ywbdxxm/MC100/MC100-SCHEMATIC-REVIEW.md

# MC100 原理图功能与电气复核

复核日期：2026-09-08。设计依据：立创 EDA 专业版云工程 `MC100` 当前五页原理图及已完成的原理图/PCB 网络对账。本文是审查结果，不是样机测试合格证；本次没有修改 EDA 电路。

**结论：主控、充电、PDM 采音、SDMMC 存储的架构具备实现目标的基础，未发现已核对引脚的错接、短路或漏接。明确的功能限制是关机文件完整性；充电计时、USB 输入和供电余量仍有具体待验证项。麦克风接线未发现明确错误，F02 属于资料澄清与样机验证，不应与已确认的硬件功能限制等同。所有功能的整机验收仍须实测。**

用户已确认电池已选定，为带独立 10 kΩ NTC 的三线电池。电池具体型号、容量、保护板参数、NTC 曲线及 microSD 型号尚未记录在本项目中。本文按现有产品目标讨论 1200 mAh，不把它当作用户已经确认的电池实参。

## 1. 主要发现

### F01 高优先级：拨动 OFF 无法保证先保存录音

**确定的硬件能力限制。** P2 的 SW1.1 接 `+VSYS_RAW`，SW1.2 接 `LDO_EN`，SW1.3 未连接，R5=100 kΩ 下拉；P1 的 U2.3 是 LDO EN。没有 MCU 开关检测线、供电保持或软件关断控制。U2 关闭后还会主动放电输出电容。[S1，第 14 页]

因此，用户在 SD 写入、WAV 文件头更新或文件系统元数据更新时拨到 OFF，会直接中断供电。定期同步、临时文件和上电修复可降低损失，但不能保证每次关机文件完整，也不能仅凭它们承诺已完成文件永远不受影响。

处理建议：若正常关机必须完整保存，增加“关机请求 -> MCU 收尾 -> 确认 SD 写入结束 -> 受控断电”的电路。若保留目前的直接断电方式，产品要求必须接受经过所选卡型实测确定的损失和恢复边界。低电检测同样只能让固件提前收尾，当前 MCU 不能关闭 LDO。

### F02 资料澄清与样机验证：麦克风 DATA 电平

**接线未发现明确错误，建议保留当前麦克风接口用于样机验证；目前没有仅凭本项就必须改线、增加电平转换或更换麦克风的依据。** P4 的 U4.1 `PDM_DATA` 直连 U3.5 / GPIO1；麦克风与 S3 均由 3.3 V 系统供电，麦克风支路经过 FB1。供电、引脚和 1.024 MHz 目标时钟范围匹配。[S2，第 1-3 页]

复核澄清：原先将本项列为高优先级，未充分区分“规格资料不足”与“已确认功能缺陷”，现调整分类。下表的原始数值及缺少实际负载下输出保证这一事实不变，调整分类不代表已测得电平合格。

| 方向/指标 | 厂商原表 | 按两端均为 3.3 V 换算 |
| --- | --- | --- |
| ZTS6872SE Logic Input/Output High 最小值 | 0.65 × VDD，Iout=1 mA | 2.145 V |
| S3 输入 VIH 最小值 | 0.75 × VDD | 2.475 V |
| ZTS6872SE Logic Input/Output Low 最大值 | 0.35 × VDD，Iout=1 mA | 1.155 V |
| S3 输入 VIL 最大值 | 0.25 × VDD | 0.825 V |

以上来自麦克风 DS-1.6 第 3 页原表及 S3 v2.2 第 62 页表 5-4。[S2、S3] 若把麦克风合写的输入/输出指标按输出保证边界比较，高、低电平各差 0.330 V。这是手册边界值的比较，不是板上测得的电平差，也不足以判定实际 DATA 直连不兼容。现有资料尚不能给出完整的最不利条件静态噪声裕量保证。

麦克风把输入和输出电平合写在同一行，测试负载为 1 mA；S3 实际是高阻输入，原表输入漏电流最大值为 50 nA，另有输入电容和 PCB 动态负载。较轻的负载下实际输出可能更接近电源轨，但这一点还没有厂家补充规格或本板实测支撑。先取得钰太对 DATA 输出 VOH/VOL 的定义及实际负载、工作电压和温度范围下的保证，并在样机 S3 引脚处测量有效采样窗口内的 DATA 高低电平、振铃及建立/保持时间，覆盖 SD 写入和 USB 插拔工况。只有确认裕量不足，或量产所需保证始终无法取得时，再评估缓冲器或替代麦克风；不以表格歧义直接要求改板。

反向 CLOCK 的静态门限比较没有同样的缺口：S3 高阻负载 VOH≥0.8×VDD、VOL≤0.1×VDD，可满足麦克风原表的 0.65/0.35 门限；动态波形仍需测试。[S2、S3]

### F03 中优先级：安全充电计时需要按公差和实际电池复核

P1 的 R3=3 kΩ，R2=46.4 kΩ。BQ24073 的 KISET 为 797/890/975 AΩ，KTMR 为 36/48/60 s/kΩ；两只电阻为 1%。[S4，第 13、34 页]

| 项目 | 计算结果 |
| --- | --- |
| 标称快充电流 | 890 / 3000 = 296.7 mA |
| 含上述公差的设定电流范围 | 约 263.0-328.3 mA，未计动态限流/热调节 |
| 标称快充安全计时 | 10 × 48 × 46.4 / 3600 = 6.187 h |
| 含上述公差的计时范围 | 约 4.594-7.811 h，按未减速的计时条件 |

文档原来的“约 6.25 小时”来自 46.8 kΩ 的示例计算，应按当前 46.4 kΩ 写为约 6.19 小时。更重要的是，若沿用 1200 mAh、约 5-6 小时充满的预估，不能仅凭标称 6.19 小时认定计时余量充足。

这不证明一定会提前超时：BQ24073 在 DPPM、输入 DPM 或热调节减小充电电流时会同比放慢计时，NTC 故障时暂停计时。[S4，第 28-29 页] 应结合所选电池的充电曲线，覆盖低电、边录边充及公差条件；不足时重新选定 TMR 阻值，同时保留适合电池的安全时间限制。U1 的 CHG# 未接 MCU/LED，超时故障目前也不能由固件直接读取。

### F04 中优先级：USB 输入电容没有显式的浪涌余量

P1 的 C2=10 µF、C10=100 nF 均直接跨接 `+VBUS_USB` 与 GND，标称合计 10.1 µF。BQ2407x 原文要求器件前端的输入电容小于 10 µF，因这部分充电电流不经过芯片内部限流；后级大电容受限流保护不能代替前端约束。[S4，第 21 页，§9.3.4.1、图 9-2]

当前标称选值没有为该约束留出余量。实际插入浪涌还取决于电容公差、随电压变化的电容值、供电源和连接阻抗，不能只凭 10.1 µF 断言实测一定超标。建议把 C2 复核为有公差余量的输入电容值，例如评估 4.7 µF，并验证输入稳定性及插入电荷/电流。

另外，EN2 固定接地、EN1 固定接 VBUS，使充电器始终使用 USB500 模式。R1=3 kΩ 不是当前 500 mA 档位的设定来源，固件也不能切换 USB100 或 USB suspend。USB500 是芯片限流模式名称，不等于整机完成了 USB 主机端口枚举、挂起或 Type-C 供电合规验证。连接电脑的兼容性仍须单独验证。

### F05 中优先级：1 A LDO 标称不能替代温升和低电供电验证

U2 确认为 `TLV75733PDBVR`，是无裸露散热焊盘的 DBV SOT-23-5。引脚和 EN 接法正确，输入/输出电容标称值处于手册建议范围。[S1，第 3-6 页] 不应引用 DYD 带散热焊盘版本的热参数。

在 USB 有效且供电足够时，BQ24073 OUT 标称为 4.4 V。[S4，第 6 页] LDO 耗散约为 `(4.4-3.3) × Iload`。举例，持续 300 mA 时为 0.33 W；DBV 的 JEDEC 测试板热阻 231.1 °C/W 对应约 76 °C 温升，EVM 条件下则为 100.8 °C/W。这些是不同测试板数据，不能当作 MC100 实际热阻或上下界。[S1，第 5 页] 必须在装壳、边录边充及最长 SD 忙周期下测温、测电源跌落。

电池低电时 LDO 不升压，进入 dropout 后瞬态表现会变差；从 dropout 恢复还可能有过冲。[S1，第 14 页] 电池 ADC 阈值必须保证先停止写盘，并避免低电复位后反复挂卡/写盘。当前电路不具备软件彻底断电能力。

## 2. 已确认的连接与功能基础

以下结论限于列明的原理图连接及所引用的器件能力，不表示 F01-F05 已解决或样机已通过验收。

| 模块 | 本次核对 | 结论/约束 |
| --- | --- | --- |
| 电池接口 J1 | 1 脚正极经 R4=0 Ω 到 BAT；2 脚到 TS；3 脚 GND | 与用户确认的三线 NTC 电池形式匹配；实物线序必须为 BAT+/NTC/BAT-，NTC 另一端接 BAT- |
| BQ24073 | BAT 2/3、OUT 10/11 均连接；IN 13、GND 8/17；CE#、TD 接地；TS 到 J1.2 | 充电和终止使能；系统/充电共用 USB500 输入预算；管脚定义符合 BQ24073 列 [S4，第 8-9 页] |
| 电池温度检测 | 三线 10 kΩ NTC 已确认；TS 未用固定电阻旁路 | 在典型 75 µA 偏置下，25 °C 的 10 kΩ 对应 0.75 V；典型冷热阻值门限约 28 kΩ / 4 kΩ。温度值依赖实际 NTC 曲线及误差 [S4，第 13-14 页] |
| LDO/开关 | U2 1 IN、2 GND、3 EN、4 NC、5 OUT；SW1 驱动 EN，R5 下拉 | 可以实现开关系统电源、关机插 USB 充电；不能实现提前收尾关机 |
| MCU 最小系统 | U3 为 ESP32-S3-MINI-1-N8；3V3、全部地脚、EN 10 kΩ/1 µF、GPIO0 10 kΩ/测试点 | 已核对模组焊盘映射；USB 下载及 BOOT/EN 测试入口存在 [S5，第 10-11 页] |
| PDM 麦克风 | U4 1 DATA -> GPIO1，4 CLOCK 经 R14=22 Ω -> GPIO2；2 SELECT、3 GND 接地；5 VDD 经磁珠供电 | 供电、脚序、去耦和时钟范围匹配；DATA 电平见 F02 |
| PDM 转 PCM | I2S0 硬件支持 64 倍降采样；1.024 MHz / 64 = 16 kHz | 能支持目标格式；SELECT=0 在下降沿后驱动、上升沿后高阻，应验证固件的有效槽位/采样沿；启动稳定时间最大 25 ms [S2，第 1-4 页；S6，第 1006 页] |
| SDMMC 1-bit | GPIO8 CMD、GPIO7 经 R22=22 Ω 到 CLK、GPIO6 DAT0；CMD/DAT0-DAT3 均有 10 kΩ 上拉 | 符合 S3 GPIO 矩阵及官方 SD 上拉要求；未接 MCU 的 DAT1-DAT3 也已上拉 [S6，第 1195 页；S7] |
| 卡检测 | J3 独立 CD 接 GPIO5，R20=10 kΩ 上拉；卡座壳地已接 | 与总线 DAT3 独立；实物 CD 开闭状态仍需通断测量 |
| USB 数据 | CC1/CC2 各 5.1 kΩ 下拉；两组 D- 合并经 22 Ω 到 GPIO19，两组 D+ 合并经 22 Ω 到 GPIO20 | 双面插头对应的数据脚均已连接，未发现 D+/D- 对调；浪涌及供电模式见 F04 |
| LED | U3.25 / GPIO21 经 R8=3.3 kΩ 驱动 LED1 | 实际 GPIO 是 21；网络名 `GPIO7_LED` 会误导固件，GPIO7 实际用于 SD CLK |
| 电池 ADC | GPIO4，R6=1 MΩ / R7=330 kΩ，C11=100 nF | 4.2 V 对应约 1.042 V；分压耗流约 3.16 µA，RC 时间常数约 24.8 ms；需校准、等待稳定并检查关机漏电 |

BQ24073 原表的约 0 °C / 50 °C 温度说明针对 Vishay Type 2、R25=10 kΩ 的 NTC 曲线，不能推广到任意 10 kΩ 电池。所选电池的允许充电温度、NTC 曲线和线序需要形成供应商规格记录，再验证低温、高温、NTC 开路/短路均暂停充电。[S4，第 13-14、29 页]

## 3. 产品功能判定

| 产品目标 | 现有硬件判定 | 尚需证据 |
| --- | --- | --- |
| 持续监听、人声触发录音 | 架构支持；监听时 S3 和 PDM 必须持续工作 | F02 接口验证、实际 VAD 漏检/误触发、任务调度及功耗 |
| 16 kHz / 16-bit / mono | 支持，数据率 32,000 byte/s | 实际采样率、有效声道、噪声与掉帧测试 |
| 2 秒预录、静音后收尾 | 2 秒 PCM 需 64,000 byte；有实现基础 | N8 无 PSRAM，VAD/任务栈/DMA/预录/写盘缓冲的峰值内存需联合验证；不能推定任意 AI 模型均可用 |
| microSD 长期存储 | 1-bit 带宽足以承载 PCM | 所选卡的最长忙时间、待机/写入电流、写入寿命、满卡/坏卡/拔卡处理 |
| 滑动开关开关机 | 可以直接切换系统供电 | 正常关机文件完整性未满足保证条件，见 F01 |
| 关机充电、边充边录 | Power Path 架构支持 | 电池实参、F03 计时、F04 USB 输入、F05 温升和切换波形 |
| 充电中/充满状态指示 | 当前没有专用状态通道 | PGOOD#/CHG# 均未连接；不能把 GPIO21 的系统 LED 当作可靠充电状态灯 |
| 单次充电工作 24 小时 | 未证实 | 若电池为 1200 mAh、可用容量按 80%，平均电池电流上限为 40 mA；现有设计目标 35 mA 仍须覆盖真实语音占比和 SD 卡实测 |

当前未提供 MC100 固件工程和已验证固件版本，因此本次没有固件构建、刷机、录音、温升或续航测试。S7 使用现有设计文档引用的 ESP-IDF v6.0.2 官方资料核对硬件要求，不代表固件已经选用该版本。

## 4. EDA 检查结果

| 页 | 放置项 | 官方原理图 DRC | 短接桥/孤立导线检查 | 严格检查总结果 |
| --- | ---: | --- | --- | --- |
| P1_POWER_PATH | 17 | 0 项 | 0 项 | 通过 |
| P2_POWER_CONTROL | 8 | 0 项 | 0 项 | 通过 |
| P3_MCU_DEBUG | 10 | 0 项 | 0 项 | 通过 |
| P4_USB_AUDIO | 10 | 0 项 | 0 项 | 未通过：1 条图签告警 |
| P5_SDMMC_STORAGE | 11 | 0 项 | 0 项 | 通过 |

P4 已通过页面 UUID 直接读取图签：`Name`、`Drawed`、`Description` 为空，产生 `missing-titleblock`。这是文档完整性问题，未发现对应的电气违规；仍不能把“五页严格检查全部通过”作为交付状态。

此前同日完成的原理图/PCB 对账为 56 个放置项、234 个焊盘记录、无网络差异；PCB 官方 DRC 为 0 项。本次以五页原理图的语义网络、严格检查和数据手册复核为主，没有把此前 PCB DRC 当作热设计、阻抗、声孔、ESD 或整机可靠性测试。

## 5. 样机验证顺序与剩余边界

1. 接电前核实电池正负极/NTC 实物线序、保护板和 R4 电流能力；量测电源对地阻抗。验证两种开关状态，以及电池/USB 各种接入顺序。
2. 用实际电池或电池模拟设备完成充电全过程，记录 IN/BAT/OUT/TS、电流及温度；核对终止、计时和冷热保护。保护板截止不能替代录音系统的提前低电收尾。
3. 测量 3.3 V、EN 和复位波形，覆盖启动、SD 写入、低电及 USB 插拔；测试装壳温升。关机时测 ADC/USB 引脚是否向失电系统注入电流，并记录实际关机电流。
4. 先验证连续原始 PCM：1.024 MHz PDM 时钟、有效采样窗口内的 DATA 裕量、正确声道及启动稳定时间，再加入 VAD 和 2 秒预录。正常运行应零丢帧，异常必须有计数和明确状态。
5. SD 从 20 MHz 验证，稳定后再评估 40 MHz；记录最长忙时间并据此验证缓冲容量。完成满卡、无卡、故障卡、插拔和长录音测试。
6. 在录音写入、文件头/元数据同步、文件轮换时分别执行不少于 100 次随机硬关机，检查当前文件、已完成文件及文件系统；这些次数是项目验证目标，不是已经完成的结果。
7. 以选定电池、选定 SD 卡、装壳和实际语音占比完成 24 小时电流积分/续航测试。再确认底部进音声孔、密封/透声膜、佩戴摩擦噪声和接口静电表现。

本次未取得 J1/J2/J3/SW1 全部连接器的原厂机械图及实物通断证据，未逐项完成无源器件耐压、直流偏压曲线和浪涌额定值审核。已有库符号/PCB 焊盘的一致性不等于这些独立验证已经通过。USB/SD 接口当前没有专用板载 ESD 保护，相关鲁棒性属于未验证项。

## 6. 证据与版本

关键表格均回看哈希一致的原 PDF 页面。已有 ESPDocs 语料用于定位；本次对未索引的麦克风和 LDO，先评估原生文本，再对麦克风第 1-4 页、LDO 第 3-6 页进行本地 Docling 表格/结构提取，并按原页复核。单次提取结果与截图不作为项目设计正本。

| 编号 | 精确资料/版本 | 本次相关物理 PDF 页 |
| --- | --- | --- |
| S1 | [TI TLV757P，SBVS322C，2024-03](../docs/PMIC/TLV757P.pdf)；按 DBV 封装列取值 | 3-6、14 |
| S2 | [钰太 ZTS6872SE，DS-1.6](../docs/MIC/C6E5017425694CD9DA32466A7E3CEEEF.pdf) | 1-4 |
| S3 | [ESP32-S3 芯片规格书，中文 v2.2](../docs/ESP32-S3/esp32-s3_datasheet_cn.pdf) | 62，表 5-4 |
| S4 | [TI BQ2407x，ZHCSIF0N，2021-10](../docs/PMIC/bq2407x.pdf)；按 BQ24073 列取值 | 6、8-9、13-14、21、28-29、34 |
| S5 | [ESP32-S3-MINI-1/MINI-1U，中文 v1.7](../docs/ESP32-S3/esp32-s3-mini-1_mini-1u_datasheet_cn.pdf)；模组管脚为此前同日已复核依据 | 10-11，表 3-1 |
| S6 | [ESP32-S3 技术参考手册，中文 v1.8](../docs/ESP32-S3/esp32-s3_technical_reference_manual_cn.pdf) | 998、1006、1195 |
| S7 | [Espressif ESP-IDF v6.0.2，SD Pull-up Requirements](https://docs.espressif.com/projects/esp-idf/en/v6.0.2/esp32s3/api-reference/peripherals/sd_pullup_requirements.html)；读取同版本官方 RST 源文件，按 ESP32-S3 条件解释 | 总要求、SOC_SDMMC_USE_GPIO_MATRIX / esp32s3 分支 |

S6 第 998 页的下采样公式与第 1006 页位定义存在不一致；本次以第 1006 页明确的 `0 -> 64、1 -> 128` 位定义核对 64 倍能力，不依据第 998 页公式推导寄存器配置。固件应使用已选 SDK 的对应驱动，并实测输出采样率。

| 资料 | SHA-256 |
| --- | --- |
| S1 | `d9372b60e97388b566b571a335b771255d3654306ce55c265e62a51f5a9709a9` |
| S2 | `0c206c8147227ef4b88e4fcd5a20196f24c0b13539ad8e38918a7c556bd545bf` |
| S3 | `adee5f18f1b565cf386f0b3feed7c437bcc1a8e57619e922198da2d47f96b400` |
| S4 | `2dbe769d0d1ddf698c8a118394787e1e450714cf38b33df77f43695f9ffc91a9` |
| S5 | `a4c94c131b2a2b37c46b2f65495c6f5fdbf001f3a357fee6035190a005663816` |
| S6 | `08b5edd2bf196eb27316d0b94fb50201d8faa5d75b1f2716ff83e1452b229500` |
