ywbdxxm/MC100/.superpowers/sdd/2026-09-25-mc100-audio-level/task-2-report.md

# Task 2 report: portable PCM processing

## Result

Implemented the stateful fixed point PCM filter for MC100 audio. The filter owns a Q16 DC estimate,
input and output peaks, and a clipped sample counter. It validates its arguments before mutating
state or samples, uses 64 bit intermediates, updates the DC estimate with the specified `/ 512`
rule, applies gain before the single Q16 conversion, clamps to signed 16 bit range, and records
peak magnitudes with 32768 represented for `INT16_MIN`.

## Files

- `firmware/components/mc100_audio/include/mc100_pcm_filter.h`
- `firmware/components/mc100_audio/pcm_filter.c`
- `firmware/tests/test_pcm_filter.c`
- `firmware/components/mc100_audio/CMakeLists.txt`
- `firmware/host/CMakeLists.txt`

## TDD evidence

The focused host test was first run against the unimplemented stub and failed at the identity
assertion (`MC100_OK` expected, `MC100_INVALID` returned). After implementation the same focused
test passed.

## Verification

Environment: VS 2022 Build Tools 17.14.40 Developer PowerShell, MSVC 19.44, Espressif CMake 3.30.2,
Ninja 1.12.1, C11.

Commands:

```text
cmake -S firmware/host -B firmware/out/host-audio-task2 -G Ninja -DCMAKE_BUILD_TYPE=Debug -DMC100_ENABLE_FUTURE_RUNTIME_TESTS=OFF
cmake --build firmware/out/host-audio-task2 --target test_pcm_filter
ctest --test-dir firmware/out/host-audio-task2 -R '^pcm_filter$' --output-on-failure
```

Result: `pcm_filter` passed.

```text
cmake -S firmware/host -B firmware/out/host-audio-task2-full -G Ninja -DCMAKE_BUILD_TYPE=Debug -DMC100_ENABLE_FUTURE_RUNTIME_TESTS=OFF
cmake --build firmware/out/host-audio-task2-full
ctest --test-dir firmware/out/host-audio-task2-full --output-on-failure
```

Result: all 17 default host tests passed.

## Coverage

Host vectors cover bypass identity, full negative peak magnitude, constant offset removal, the
`[0, 1000]` DC step, the low level `[0, 1]` step at 8x, gain and saturation boundaries, clipping
counts, invalid arguments with no mutation, and whole-buffer versus chunked state continuity.

## Scope and concerns

No product capture loop, EVT path, writer, or SD-card files were changed. Target firmware and physical
microphone behavior were not exercised in this host-only task.
