ywbdxxm/MC100/MC100-PCB-REVIEW.md

# MC100 PCB 投板前复核

复核日期：2026-09-09。权威对象：立创 EDA 云工程 MC100，项目 UUID `b3848130180c4bfb8066a08134a93953`，PCB1 UUID `588d07309976e518`。

本次直接读取当前 PCB 和五页原理图，运行原生 DRC，并于 01:03:19 重新导出 Gerber。00:55:33 的初始数据与 01:27:34 的收尾数据对比确认：元件、焊盘、走线、过孔、铺铜、填充、禁布区、丝印和规则没有变化。本轮未修改电路或封装，未提交制造订单。

**结论：未发现新的短路、断线或原理图与 PCB 网络不一致。之前的麦克风实心锡膏开口和 USB/SD 走线中段跨电源分割问题已经解决。建议再完成 USB 局部回流、SD 去耦、R22 和 LDO 输出电容的布局收尾，并按实际制造叠层确认阻抗后打样。**

这些布局建议涉及信号及供电余量，尚未通过样机测量量化影响；不能将其描述为已发生的烧录、录音或写卡故障。DRC 通过也不能代替真实功能验证。

本轮 [检查数据及制造副本](../.easyeda/reviews/MC100-20260909-0051/)；[2026-09-08 历史复核全文](../.easyeda/reviews/MC100-20260909-0051/previous-review-20260908.md)。历史文件中的“当前”均指旧版。

## 1. 建议投板前收尾的项目

### P06 USB 局部参考铜与换层回流

USB_P/USB_N 主干已经从 Bottom 移到 Inner2，参考 Inner1 地平面。新 Gerber 中，直线中心线在自身信号过孔周围 0.65 mm 之外，没有再跨过参考铜的空白区。进一步按完整线宽检查，仍有两处局部边缘投影落入地平面的过孔避让：

| 位置 | 当前证据 | 建议 |
| --- | --- | --- |
| NTC 过孔附近 | `$1N267` 过孔位于 EDA (655, 231.9708) mil，即 Gerber (16.6370, 5.8921) mm。USB_N 的边缘在 x 16.3357-16.9383 mm、y 5.3305-5.4182 mm 局部进入其 Inner1 反焊盘范围，投影面积约 0.0358 mm² | 将 NTC 过孔稍远离 USB 对，保持两根 USB 线原有平行关系，并重新核对参考地 |
| MCU 端换层附近 | USB_P 在 Gerber x 42.5261-42.6589 mm、y 5.1137-5.2270 mm 处，线边缘接近 USB_N 过孔的反焊盘；自身过孔 0.65 mm 范围以外的投影面积约 0.00326 mm² | 整理差分对的过孔和扇出，减小相互反焊盘对直线段的影响 |
| 两端换层地回流 | 连接器端两颗 USB 过孔距最近独立 GND 过孔约 3.64/4.08 mm；MCU 端约 2.50/3.31 mm | 在两端的差分换层附近补就近地过孔，按原厂建议为差分对提供成对的地回流 [D2] |

上表是几何位置和最近独立地过孔距离，不是实测回流长度或阻抗。信号自身过孔处的反焊盘是正常结构，不把它整体判作跨分割缺陷。0.65 mm 是本次分析排除正常过孔邻域的口径，不是厂商规定的安全距离。

[USB 局部定位图](../.easyeda/reviews/MC100-20260909-0051/usb-reference-details.png)：灰色为实际 Inner1 地铜，红色仅标出自身过孔邻域以外的线边缘投影空白。此项是局部信号余量建议，不表示 NTC 与 USB 短路。

### P02 SD 高频去耦 C20 仍离卡座较远

C20=100 nF，仍位于 EDA (960, 800) mil。J3.4 是 microSD 电源脚。

| 电容 | 容量 | 电源焊盘到 J3.4 的中心直线距离 |
| --- | --- | ---: |
| C18 | 47 uF | 5.69 mm |
| C19 | 10 uF | 7.83 mm |
| C20 | 100 nF | 9.38 mm |

优先将 C20 移到 J3.4 附近，地端就近接地平面；空间允许时把 C19 一起收拢。当前 C20 地焊盘距最近独立地过孔约 3.29 mm，也值得同时缩短。电源铜面和远处的大电容已存在，但高频去耦仍应缩短供电与接地回路。

### P01 SD 时钟串阻 R22 仍在卡座端

R22=22 ohm，仍位于 EDA (705, 920) mil。线路为 U3.11 / GPIO7 -> `SDMMC_CLK_MCU` -> R22 -> `SD_CLK_CARD` -> J3.5。MCU 到 R22 的网络铜线总长约 19.34 mm，R22 到卡座约 2.36 mm。

如果以源端串联阻尼为目的，建议把 R22 放到 U3.11 附近，使电阻之前的走线尽可能短。当前摆放将大部分走线留在阻尼电阻之前。此建议基于串联阻尼的作用位置，并非已测得时钟振铃；实际效果还取决于驱动边沿、卡负载及叠层。

### P07 LDO 输出电容 C8 宜靠近 U2

U2 为 TLV75733PDBVR，当前位置 EDA (1475, 240) mil；C8=22 uF，位于 (1425, 75) mil。C8 电源焊盘距 U2.5 / OUT 约 5.45 mm；C9=100 nF 的对应距离约 2.77 mm。输入旁的 C5 距 U2.1 约 2.98 mm。

建议优先把 C8 和 C9 收拢到 OUT/GND 附近，并缩短接地回路。TI 的布局要求是输入、输出电容尽可能靠近器件，同时使用铜面和附近过孔改善散热 [D5]。当前连接完整，不能仅凭这些距离认定 LDO 已失稳或一定掉压。

## 2. 已解决及已通过的检查

### P04 麦克风声孔与锡膏开口保持正确

U4 仍使用修正后的局部封装 `588d07309976e518_4dd9d81a1a9fda28`，其焊盘、填充、轮廓和属性记录与 2026-09-08 已验证版本相同。本次新导出的制造数据也确认：

| 项目 | 新 Gerber 实测 |
| --- | --- |
| 声孔 | (25.65387, 28.26487) mm，直径 0.60000 mm，属于 NPTH |
| 接地环锡膏 | 4 个互不相连的环形扇段，四个矩形开口仍保留 |
| 中心留空直径 / 外径 | 1.024943 / 1.625019 mm |
| 四处分隔 | 每处约 0.199998 mm |
| 与声孔重叠面积 | 0 |
| 锡膏距声孔边缘 | 最小约 0.212472 mm |

这些尺寸与 ZTS6872SE DS-1.6 第 9 页的钢网建议一致 [D1]。小数差异来自圆弧近似和 Gerber 取整。[本次实际 GTP 图](../.easyeda/reviews/MC100-20260909-0051/current-mic-paste.png)；[历史修复证据](../.easyeda/reviews/MC100-MIC-FIX-20260908/)。SMT 工厂仍应使用修复后的制造文件及钢网。

### P05 旧的线路中段跨电源分割已消除

新版本的 Inner2 为大面积 GND、局部 +3V3_SYS 铜区及 USB 差分走线；旧的 +VBUS_USB、+VSYS_RAW 内层电源铺铜不再存在，两网改由实际外层走线和局部填充供电。

- USB 主干在 Inner2，两侧分别为 Inner1 地平面和 Bottom 铜层。两侧实际地铜均已核对，直线中心线在自身信号过孔邻域之外均未再跨地铜空白。实际主要参考哪侧仍取决于制造层间距。
- SD_CLK/CMD/DAT0 和 PDM 的长段仍在 Bottom，下方对应 Inner2 地铜。
- 以实际 Gerber 连通铜区识别地铜后，检查直线中心线并排除自身过孔 0.65 mm 邻域，没有再发现旧版的中段跨铜面分割。
- 完整线宽的局部边缘问题单独列在 P06，不能把“旧分割消除”扩写为全部信号完整性已经通过。

[当前信号与参考地叠加图](../.easyeda/reviews/MC100-20260909-0051/current-reference-layers.png)。本次 G1/G2 中，异网独立过孔的铜环与已识别地铜的最小几何间距约 0.257 mm，未见它们直接连进地平面。

[USB 与另一侧 Bottom 地铜叠加图](../.easyeda/reviews/MC100-20260909-0051/usb-over-bottom-reference.png)。不能仅因存在连续的 Inner1 就假定它一定是 Inner2 的最近参考层，本轮已补查另一侧，但真实阻抗仍需制造叠层。

### P03 原先六处丝印压焊盘提示未在制造文件中重现

对 C4、R8、R15、R12、R17、U1 的实际 GTO 字形及周边图形与 GTS 开窗相交检查，局部重叠面积均为 0；每个检查区域内均确认存在实际丝印图形。本次不再把这六条包围盒提示列为已确认的压焊盘问题。

R15/R12/R8 仍排得较密，部分文字与器件框接近，建议作可读性整理，优先级低于供电和信号回流。[实际丝印与阻焊叠加图](../.easyeda/reviews/MC100-20260909-0051/current-silkscreen-detail.png)。

### 连通、供电、结构与调试入口

| 项目 | 当前结果 |
| --- | --- |
| 原生 DRC | 本次 `passed=true`，`violations=[]`；用户运行的原生界面也显示 124 项检查、0 问题 |
| 原理图与 PCB 对账 | 五页重新读取；56 个放置项、234 个焊盘记录，无缺失、网络差异或采购料号差异 |
| 实际有效走线 | 255 个直线段：Top 221、Bottom 26、Inner2 8；另有 Top 圆弧 4 个 |
| 独立过孔 | 78 个，孔径均为 12 mil、外径均为 24 mil，约 0.305/0.610 mm |
| 铜区 | 可枚举铺铜 4 区，顶层静态电源填充 6 区；Inner1 另有实际 GND 平面，不因接口不可枚举而判为空 |
| 电源导线 | 实际直线宽度为 10/20 mil，并配合局部铜面；不能用是否存在同名 pour 判断供电路径是否完整 |
| U1 接地/散热 | EP 为 GND，中心有 2 x 2 共 4 颗地过孔；温升仍需样机验证 |
| U3 接地 | 模组中央 9 块地焊盘各有地过孔，焊盘网络保持一致 [D4] |
| 模组/麦克风去耦 | C15 到 U3.3 约 1.66 mm；C17 到 U4.5 约 1.56 mm |
| 开关与 LDO | SW1.1=VSYS_RAW、SW1.2=LDO_EN、SW1.3=NC；R5=100 kohm 下拉，U2 EN/IN/OUT/GND 对账一致 |
| 板框 | 实际约 50 x 30 mm，带天线外伸缺口；四个铜层都没有导出板框外铜 |
| 最小铜到板边 | Top 约 0.376 mm、Bottom 约 0.356 mm、Inner1 约 0.257 mm、Inner2 约 0.505 mm，含缺口边界 |
| 天线禁布 | 多层禁止 TRACK/COPPER/FILL/PLANE；禁布矩形与四层实际铜的相交面积均为 0 |
| TP1-TP4 | 底层分别为 GND、3V3、GPIO0/BOOT、EN/CHIP_PU，铜盘直径 0.762 mm、阻焊开窗约 0.8636 mm，实际丝印镜像正确 |
| 下载线路 | USB D-/D+ 经 R15/R12 分别到 GPIO19/GPIO20；GPIO0、EN 测试点铜连接保留。UART0 TX/RX 仍未引出；操作条件见 [烧录文档](MC100-PROGRAMMING.md) |

原生源码另保留 53 个长度小于 0.0471 mil 的极短 LINE 记录，读取接口的有效走线计数没有包含它们。上述 255 段采用同一接口口径，制造图形检查使用完整 Gerber，并未只渲染这 255 段。

### SD 与 USB 长度

本次按 U3 焊盘中心到 J3 焊盘中心重建实际导电路径，排除上拉支路，并将 R22 两焊盘之间约 0.864 mm 的跨度计入时钟路径。各路径均有两次换层；下表不包含过孔孔壁传播延迟或器件内部延迟。

| SD 信号 | 点到点长度 | 相对 CLK |
| --- | ---: | ---: |
| CLK | 22.568 mm | 基准 |
| CMD | 22.231 mm | -0.337 mm，约 -13.28 mil |
| DAT0 | 22.839 mm | +0.271 mm，约 +10.66 mil |

本次使用的 CMD/DAT0 满足原厂相对 CLK ±50 mil 的几何等长建议，长度也小于推荐的 2000 mil [D2]。[逐段路径数据](../.easyeda/reviews/MC100-20260909-0051/sd-path-lengths.json)。这不等于已做时序仿真，也不会消除 R22 位置及去耦建议。

USB 工具统计接口侧两网铜长差约 0.25 mil，MCU 侧约 0.64 mil；MCU 到串阻约 2.23/2.25 mm。接口侧统计包含 USB-C 分支，不能当成纯粹的点到点差分延迟。

## 3. 制造与样机验证边界

| 项目 | 当前尚缺的证据 |
| --- | --- |
| 阻抗 | 没有板厂确认的四层介质间距、铜厚和介电参数。USB 已换到 Inner2，10 mil 线宽、6 mil 长平行段边缘间距仍需按该层实际结构核算，不能直接认定满足 90 ohm ±10%；SD 50 ohm ±10% 同样未计算 [D2] |
| SMT | U3/C2913206 与 U4/C42372687 的现有选型需要标准型服务；最终 BOM、坐标文件、Gerber、工厂钢网需同版。TP 不作为采购器件 |
| 电池/连接器 | 用户已确认三线、10 kohm NTC 电池；实物仍需匹配 J1.1=BAT+、J1.2=NTC、J1.3=GND。连接器实际插拔空间、外壳和电池对天线的影响尚未独立验证 |
| 功能 | 未进行实体上电、USB 烧录、录音、写卡、充电或温升测试；开关关闭仍会直接关断 3V3，不具备软关机保持电路，写卡中掉电风险见 [原理图复核](MC100-SCHEMATIC-REVIEW.md) |

建议完成第 1 节收尾和叠层确认后，重新跑 DRC、导出并检查制造文件。下述 ZIP 是本次复核快照，不是已经放行的最终下单包。

## 4. 补充检查与布局评分

补充 `pcb check` 返回 `passed=false`。findings 数组实际为 49 ERROR、165 WARN、14 INFO，共 228 条；工具 summary 的 warnings=173 与数组不一致，本文采用逐条计数。

- 41 条间距 ERROR 存在单位二次换算：原始规则单位为 mil，约 5.9843 mil 被当成约 235.6 mil。例如 USB_CC2 到 C1.2 的 231.1 mil 距离被误判不够；不将这些结果当作真实间距违规。
- 8 条镜像 ERROR 来自没有渲染包围盒的库属性；实际底层 TP 位号均为 `mirror=true`。
- 59 条 silk-over-pad 中仅 6 条涉及有可见包围盒的位号，已用真实 GTO/GTS 重新判断，见 P03。
- `USB_P` 的 single-layer-via 漏计顶层圆弧；该孔实际连接 Top 和 Inner2。
- 4 个 power-not-poured 提示没有计入同网静态填充和实际走线；本轮分别核对 +VBAT、+VBUS_USB、+VSYS_RAW、+3V3_MIC。
- width-under-spec 将原始 10 mil 读成约 393.7 mil，不能据此要求全部电源线加宽到 394 mil。
- C18-C20 被按 MCU 去耦误分配；本轮用实际负载 J3 重测，保留 P02。C8/C9 的真实距离建议则保留为 P07。
- Inner1 平面不可枚举提示已用完整 G1 和原生 LAYER_FILL 记录排除；实际异网过孔与地铜隔离也已核对。
- 其余角度、宽度变化、3W、散热过孔、Mark 点等属于工艺或布局提示，需要按实际网络和贴装工艺判断，未将整份补充报告标为全部通过。

布局评分仍为 73.4/100，`fair`，七维计分、两维跳过。只是诊断，未作为放行门槛；工具未返回 `blocking[]` 字段，compact 中 `hardCollisions=0` 不能扩写为所有结构检查均通过。

| 维度 | 分数 | 主要归因与限制 |
| --- | ---: | --- |
| 功能分区 | 40 | 降级：按网络猜分组，R5/U2/J1 被扣分；没有设计意图 spec，不能据此判分区错误 |
| 信号流向 | 未测 | 无对应 spec |
| 接口边缘 | 88 | 降级：J1 与 J2/J3 位于不同边；两种接口缺少准确插头包络/开口方向 |
| 保护/去耦 | 47.3 | 降级：未识别到外部接口保护件；C18-C20 归属不准确，按 P02 重判；真实 C8/C9 见 P07 |
| 整齐度 | 65.9 | 主要是 R19/R17/R18 等朝向、间距和字号 |
| 紧凑度 | 56 | 降级：用含丝印 bbox 估计占板率，主要归因 U3/J3/J1，不能据此直接要求扩大板框 |
| 射频 | 未测 | 工具关键字未识别 MINI-1；本轮另用实际禁布区、板框及四层 Gerber 核对铜净空 |
| 可布性 | 91.2 | 降级：已布线板仍按飞线交叉估计，主要归因 U3/J2/J1 |
| 装配间距 | 100 | 降级：仅两两间距，未验证烙铁通道、实际插头和外壳 |

## 5. 证据与可追溯文件

| 编号 | 原始资料 | 本次相关位置 |
| --- | --- | --- |
| D1 | [ZTS6872SE DS-1.6](../docs/MIC/C6E5017425694CD9DA32466A7E3CEEEF.pdf) | 物理页 8-9，声孔、焊盘、钢网；沿用已回看原页的修复依据，本次复核新制造文件 |
| D2 | [ESP32-S3 硬件设计指南，本地 Release master](../docs/ESP32-S3/esp-hardware-design-guidelines-zh_CN-master-esp32s3.pdf) | 物理页 32 / 印刷页 29，USB、SDIO；本次再次查看原页 |
| D3 | [BQ2407x ZHCSIF0N，2021-10](../docs/PMIC/bq2407x.pdf) | 物理页 40，使用 BQ24073，接地/散热路径 |
| D4 | [ESP32-S3-MINI-1/MINI-1U 中文 v1.7](../docs/ESP32-S3/esp32-s3-mini-1_mini-1u_datasheet_cn.pdf) | 物理页 41，使用 MINI-1 的推荐封装 |
| D5 | [TLV757P SBVS322C，2024-03](../docs/PMIC/TLV757P.pdf) | 物理页 21，7.4.1 布局原则及图 7-7 DBV；本次查看原页 |

PDF 使用既有本地资料定位，新增 TLV 布局段落采用原生文本定位并渲染原页复核；未为本次短段落重建整份语料。各文件重新计算的 SHA-256 保存在 [源文件指纹](../.easyeda/reviews/MC100-20260909-0051/source-hashes.json)，与既有资料一致。

- [原生 PCB 快照](../.easyeda/reviews/MC100-20260909-0051/PCB1-current.epro2)
- [本次 Gerber 检查副本](../.easyeda/reviews/MC100-20260909-0051/MC100-review-Gerber-20260909.zip)，生成时间 2026-09-09 01:03:19，SHA-256 `74b0872d295227e9f3c1f1ca9768e9fe00b3153512e575dc1b88b6a1dda4f838`
- [制造几何核验](../.easyeda/reviews/MC100-20260909-0051/fabrication-verification.json)：声孔/锡膏、参考地、过孔隔离、板边、天线、测试点、丝印和去耦距离
- [原理图与 PCB 对账](../.easyeda/reviews/MC100-20260909-0051/schematic-pcb-reconciliation.json)
- [初次采集与 DRC 原始记录](../.easyeda/reviews/MC100-20260909-0051/read-pcb.json.journal.jsonl)
- [收尾数据一致性](../.easyeda/reviews/MC100-20260909-0051/freshness-verification.json)
- [补充检查](../.easyeda/reviews/MC100-20260909-0051/pcb-check.json)及[逐维评分](../.easyeda/reviews/MC100-20260909-0051/layout-score.json)

Gerber 使用 Gerbonara 解析、Shapely 核对矢量几何，曲线近似误差不超过 0.0001 mm，图像只用于定位。DRL 解析提示 G90 出现在头部之后，全部孔位仍成功读取；无文件被修改以消除该语法提示。后续 PCB/封装若有变化，应按变更范围重新核查，不能沿用本快照证明新版本。
