ywbdxxm/MC100/docs/software/2026-09-23-mc100-pm40-vad-spike.md

# MC100 Phase 1：PM40 / VAD 实板 Spike 报告

> **报告日期：** 2026-09-23
> **阶段门禁：** **OPEN（部分证据已取得，不能关闭）**
> **结论摘要：** 在本项目锁定的 ESP-IDF v6.1 / ESP32-S3-MINI-1-N8（无 PSRAM）组合上，连续 PDM RX 在固定 CPU/APB 40 MHz 配置下未能完成 `i2s_channel_enable()`；固定 80 MHz 可以连续运行。DFS 的最低频率虽然设为 40 MHz，但 PDM 活跃时实际 CPU/APB 为 80/80 MHz。因此“PDM + VAD 全程 40 MHz”目前不成立。esp-sr 2.4.7 的 VADNet1 medium 已完成**无 PSRAM target build**，并在所选串口完成模型分区加载与 VAD 配置探针；但 AFE 创建在 `SR_RINGBUF` 分配处因内部内存耗尽而失败并触发 panic，未得到帧级运行数据。该结果只约束本模型/配置/无 PSRAM tuple，不能外推为所有 esp-sr 配置均不可行；授权语料、电流和公平 VAD 对比仍未完成，VAD 仍不选型。

本报告记录 2026-09-23 的 PM/VAD 可行性实验。`firmware/spikes/pm40_vad/` 是一次性测量程序，不是产品运行时；报告中的构建、Flash 和监控证据均只针对用户授权的 **所选串口**，没有操作其它串口。当前任务状态见[验证与状态](../MC100-VALIDATION.md)。

## 1. 固定身份、范围和证据边界

| 项目 | 本轮固定值/证据 |
| --- | --- |
| 板/芯片 | MC100 V1；ESP32-S3 QFN56，revision v0.2；USB Serial/JTAG；8 MB Flash；设备标识已从公开报告移除 |
| 模组能力 | ESP32-S3-MINI-1-N8；无外部 PSRAM |
| SDK tuple | ESP-IDF v6.1，项目锁定 revision `fff9895c82d744c7237be8847347bdd1b07c6643`；target `esp32s3` |
| 音频输入 | PDM RX，16 kHz、单声道、16-bit；DMA 每帧 320 samples（20 ms） |
| VAD 探针 | vendored libfvad，mode 2；另有独立 Component Manager esp-sr 2.4.7 / VADNet1 medium target-build probe；均不代表识别质量 |
| 供电/电流 | 本轮为 USB 供电；没有电池侧校准仪器或 mA 采样，因此不产生电流结论 |
| Flash 安全快照 | 覆盖实验前读取 8,388,608 bytes；备份存于未入库的本地证据目录，SHA-256 `83696989314E4AA99DB975F5E3D9DB255FDB1EB28DBB26ADD369D4C44D757CCD` |

所有“通过/失败”只表示日志中记录的这个精确目标、SDK、配置和外设路径；构建成功不替代 PDM、VAD、功耗或长期稳定性实测。esp-sr 本轮既有 target build 证据，也有一次所选串口运行时探针：模型分区加载成功，但 AFE 创建失败；没有把该失败扩大解释为其它模型、内存策略或带 PSRAM 组合的结论。

## 2. 已执行的配置和原始证据

每个 PM 配置使用独立构建输出，然后通过所选串口烧录并监控约 10 秒；esp-sr runtime probe 另使用独立 throwaway 工程和模型分区，通过所选串口烧录、读回备份并监控到重复 panic 后停止监控。关键原始日志留在未入库的本地证据目录；下表文件名用于原档案核对，仓库不包含这些日志和二进制产物。

| 运行 | 配置 | 关键日志 |
| --- | --- | --- |
| 固定 40 MHz | `max_freq_mhz=40`, `min_freq_mhz=40` | `02-flash-pm40-20260923.log`、`03-monitor-pm40.stdout.log`、`03-monitor-pm40.stderr.log` |
| 固定 80 MHz 基线 | `max_freq_mhz=80`, `min_freq_mhz=80` | `04-flash-pm80-20260923.log`、`05-monitor-pm80.stdout.log` |
| 固定 40 MHz + 显式 APB lock 对照 | 40/40，额外 acquire `ESP_PM_APB_FREQ_MAX` | `06-build-pm40-apb.log`、`07-flash-pm40-apb-20260923.log`、`08-monitor-pm40-apb.stdout.log` |
| DFS 对照 | `max_freq_mhz=80`, `min_freq_mhz=40` | `09-build-pm40-dfs.log`、`10-flash-pm40-dfs-20260923.log`、`11-monitor-pm40-dfs.stdout.log` |

芯片识别和 Flash 读回日志分别为 `00-chip-id-20260923.log`、`01-read-flash-20260923.log`。日志 SHA-256 如需审计可由 `Get-FileHash` 对上述文件重算；报告不把生成目录当作源码证据。

## 3. PM/PDM 结果

| 运行 | PM 配置后实际时钟 | PDM 启动/持续读取 | 10 秒统计 | 结论 |
| --- | --- | --- | --- | --- |
| 固定 40 | `CPU=40 MHz`, `APB=40 MHz` | 打印 `PDM_INFO` 后，`i2s_channel_enable()` 未返回；没有 `PDM_START result`、进度或 summary | 约 10.093 s 起触发 Task WDT；反复同一回溯 | **失败：固定 40 的 PDM RX 启动路径卡死** |
| 固定 40 + APB lock | 仍为 `CPU=40`, `APB=40`；`PROBE_APB_LOCK result=0 held=1` | 与固定 40 相同，仍在启动阶段卡住 | Task WDT；无帧 | **失败：额外 lock 不能突破 40 MHz 配置上限** |
| 固定 80 | `CPU=80 MHz`, `APB=80 MHz` | `PDM_START result=0`；连续读满 | `frames=501`, `bytes=320640`, `timeouts=0`, `errors=0` | **通过本次 10 s 连续性探针** |
| DFS（max 80 / min 40） | 初始及 PDM 活跃期间均为 `CPU=80`, `APB=80` | `PDM_START result=0`；连续读满 | `frames=501`, `bytes=320640`, `timeouts=0`, `errors=0` | **PDM 可运行，但活跃期间不是 40 MHz** |

四种配置的 PDM 时钟参数均记录为 `sclk_hz=160000000`、`bclk_hz=1024000`、`mclk_hz=8192000`、DMA 总字节数 3840。固定 40 日志确实完成了 PDM 配置和 `PDM_INFO` 打印，失败发生在启用通道之后，不是“没有烧录”或“没有识别麦克风”。

### 3.1 固定 40 的故障定位

使用与 ESP-IDF v6.1 构建匹配的 `xtensa-esp32s3-elf-addr2line` 解码 WDT 回溯，核心帧为：

```text
i2s_ll_rx_update       esp_hal_i2s/.../i2s_ll.h:466
i2s_ll_rx_start        esp_hal_i2s/.../i2s_ll.h:489
i2s_rx_channel_start   esp_driver_i2s/i2s_common.c:292
i2s_channel_enable     esp_driver_i2s/i2s_common.c:1489
start_pdm              firmware/spikes/pm40_vad/main/pm40_vad_probe.c:88
run_probe              firmware/spikes/pm40_vad/main/pm40_vad_probe.c:166/179
```

`i2s_ll_rx_update()` 在 IDF v6.1 的实现是写入 `rx_update` 后等待该位清零的 busy-wait。与该回溯对应的 `components/esp_pm/pm_impl.c:460-469` 逻辑为（ESP32-S3 分支）：

```c
apb_max_freq = MIN(max_freq_mhz, apb_clk_freq);
apb_max_freq = MAX(apb_max_freq, min_freq_mhz);
```

所以在 `max_freq_mhz=40`、`min_freq_mhz=40` 时，PM 的 APB_MAX 仍被限定为 40 MHz；显式 APB lock 只报告 acquire 成功，不能把已配置的上限提高到 80 MHz。这个源码约束、实际 `CPU/APB=40/40` 和 `rx_update` 回溯相互吻合。报告将其记为“当前 SDK/配置下的 PDM 启动不兼容”，不外推到其它 IDF 版本、其它 I2S 模式或其它芯片。

## 4. libfvad 工程探针（不是选型结论）

libfvad 在无 PSRAM 的目标上成功初始化：

```text
VAD_INIT ptr=1 mode_result=0 rate_result=0
heap_before=380472 largest_before=319488
heap_after=379700 largest_after=319488
```

这里的初始化前后差值是约 772 bytes 内部堆；`largest_before/after` 均为 319488 bytes。固定 80 和 DFS（PDM 活跃时 80 MHz）均对 501 个 20 ms 帧执行了 `fvad_process`：

| 运行 | VAD 帧 | `vad_speech` | 最小 / 平均 / P95 / 最大（µs） | summary |
| --- | ---: | ---: | ---: | --- |
| 固定 80 | 501 | 4 | 389 / 394 / 402 / 638 | `05-monitor-pm80.stdout.log` |
| DFS（requested 40，实际 80） | 501 | 4 | 389 / 394 / 401 / 644 | `11-monitor-pm40-dfs.stdout.log` |

`vad_speech=4` 仅是本轮板上环境输入的二值输出计数，不能解释为召回率、误启动率或人声质量。固定 40 因 PDM 未启动，没有可比的 VAD 运行数据。

## 5. esp-sr VADNet target build 与运行时探针

使用独立的 Component Manager throwaway 工程构建 `espressif/esp-sr==2.4.7`，目标为 `esp32s3`，关闭 PSRAM（生成的配置没有 `CONFIG_SPIRAM`），并启用 `CONFIG_SR_VADN_VADNET1_MEDIUM=y`。探针代码把 AFE 内存策略设为 `AFE_MEMORY_ALLOC_MORE_INTERNAL`。Windows 长路径会使 GCC 无法创建依赖文件，因此构建使用了短的临时物理路径；源代码和完整日志仍保存在被忽略的 probe/evidence 目录。

结果：**target build PASS**。Component Manager 解析 esp-sr 2.4.7 及 cjson 1.7.19~2、dl_fft 0.7.0、esp-dsp 1.8.0；模型报告为 `vadnet1_medium` 281.16 KiB；生成 ESP32-S3 镜像 `mc100_esp_sr_probe.bin`（0x846a0 bytes），3 MiB app 分区剩余 83%。完整日志和生成物保存在本地忽略的 `firmware/out/phase1-evidence/`；该目录不属于版本库，缺失时不能作为可复核仓库证据。日志中的 Kconfig `default False` 提示来自上游 esp-sr/IDF 配置解析，未阻止构建。

本结果只证明“无 PSRAM 的 ESP32-S3 target image 可构建”。随后用该镜像在 **所选串口** 做了运行时探针，得到：

```text
SR_PROBE_START target=esp32s3 spiram_config=0
SR_HEAP phase=before_models internal_free=384368 internal_largest=319488 spiram_free=0
SR_MODEL_INIT result=OK count=1
SR_MODEL index=0 name=vadnet1_medium
SR_AFE_CONFIG checked vad_init=1 vad_model=vadnet1_medium memory_mode=1 pcm_channels=1 mic=1 rate=16000
SR_HEAP phase=before_afe internal_free=383384 internal_largest=319488 spiram_free=0
SR_RINGBUF: sr_rb_create: Memory exhausted
Guru Meditation Error: Core 0 panic'ed (StoreProhibited)
```

**运行时状态：INIT FAIL / BLOCKED。** 未出现 `SR_AFE_CREATE` 成功、每帧处理或 PDM-fed 统计。回溯为 `flash_model_info` → `model_create` → `afe_init_vad` → `afe_create_from_config` → `app_main`；完整重复日志位于本地忽略的 `firmware/out/phase1-evidence/`。这是本次 `vadnet1_medium`、无 PSRAM、`AFE_MEMORY_ALLOC_MORE_INTERNAL` 配置的内部内存门禁失败，不足以断言其它 esp-sr 模型或内存策略不可行。实验前的 8 MiB Flash 备份为 `esp-sr-runtime-before-20260923.bin`（SHA-256 `82D4D76EC9D3ADC83BEAFBC14C4310DCF1870D26ABC97C8F48458F99FAF80E8E`）；运行结束后未恢复或再烧录其它镜像，板子保留在 probe 镜像的重启状态。

## 6. Phase 1 尚未关闭的项目（必须保持 OPEN）

| 项目 | 状态 | 不能替代的证据 |
| --- | --- | --- |
| esp-sr VADNet 无 PSRAM target build | **PASS** | esp-sr 2.4.7 / VADNet1 medium image 已生成；证据为上面的独立 build log |
| esp-sr VADNet init/runtime | **INIT FAIL / BLOCKED** | 模型分区加载和发现成功；`AFE_MEMORY_ALLOC_MORE_INTERNAL` 下 `sr_rb_create` 报 `Memory exhausted`，随后 `StoreProhibited` panic；无 AFE/帧数据。其它模型/内存策略尚未评估 |
| esp-sr vs libfvad 公平比较 | **OPEN** | esp-sr 未取得可运行的 AFE/帧级数据，缺少同一输入、同一时钟、同一内存口径下的两者数据 |
| 授权语料召回/误启动 | **NOT RUN** | 没有授权语料、标注、召回率、P95 决策延迟和每小时误启动统计 |
| 电池侧电流（40/80、PDM+VAD） | **NOT RUN** | USB 供电且未接校准电流仪；不能把设计估算 23–26/40–43 mA 当成实测 |
| VAD 选型 | **OPEN** | 计划要求无 PSRAM 可运行性、资源/延迟和语料结果共同支撑；目前条件不完整 |

## 7. Phase 1 决策和后续动作

1. 对本项目的精确 tuple，**不能放行“固定 CPU/APB 40 MHz 连续 PDM + VAD”**。删除 PM lock 或把请求频率写成 40 都不能构成证据。
2. DFS `80/40` 只能作为“允许空闲最低 40 MHz、PDM 活跃回到 80 MHz”的候选策略；它不满足全程 40 MHz 命题，功耗必须等实测电流后再评估。
3. libfvad 已证明“在 80 MHz 路径上可初始化并处理 16 kHz/20 ms 帧”；esp-sr 已证明“无 PSRAM target image 可构建”，但本次 `vadnet1_medium` AFE 创建因内部内存耗尽而 **INIT FAIL / BLOCKED**。这不是对其它 esp-sr 配置的普遍否定；仍需评估可行的模型/内存策略，之后才能做同口径资源/延迟比较和授权语料评估。
4. 在上述缺口完成前，Phase 1 gate 保持 **OPEN**，最终设计 §4 的功耗估算和 §8 的风险项不得改写为已验证；Phase 2 的占位 VAD 也不能被本报告替换成正式 VAD。

## 8. 可复核的原始 summary 行

```text
固定 80：SPIKE_SUMMARY requested_mhz=80 frames=501 bytes=320640 timeouts=0 errors=0 cpu_min_mhz=80 cpu_max_mhz=80 apb_min_hz=80000000 apb_max_hz=80000000 vad_frames=501 vad_speech=4 vad_min_us=389 vad_avg_us=394 vad_p95_us=402 vad_max_us=638 heap_before=380472 heap_after=384652 largest_before=319488 largest_after=319488 stack_free=5448

DFS：SPIKE_SUMMARY requested_mhz=40 frames=501 bytes=320640 timeouts=0 errors=0 cpu_min_mhz=80 cpu_max_mhz=80 apb_min_hz=80000000 apb_max_hz=80000000 vad_frames=501 vad_speech=4 vad_min_us=389 vad_avg_us=394 vad_p95_us=401 vad_max_us=644 heap_before=380472 heap_after=384652 largest_before=319488 largest_after=319488 stack_free=5448

固定 40：无 SPIKE_SUMMARY；日志在 PDM_INFO 后出现 Task WDT，回溯落在 i2s_ll_rx_update → i2s_channel_enable。
固定 40 + APB lock：PROBE_APB_LOCK result=0 held=1；仍无 SPIKE_SUMMARY，回溯同上。
```

esp-sr target build：`esp-sr=2.4.7`、`VADNet1 medium`、`CONFIG_SPIRAM` 未启用；镜像生成 PASS。所选串口运行时：模型加载 `SR_MODEL_INIT result=OK`，AFE 创建在 `sr_rb_create` 因内部内存耗尽失败并 panic（`INIT FAIL / BLOCKED`）；没有帧处理数据。
