ywbdxxm/MC100/docs/reports/2026-09-19-evt-recording.md

# MC100 USB 台架录音开发验证

## 本轮范围

本轮使用一块 MC100 开发板，通过事先确认的串口连接。已插 SD 卡、未接电池，仅 USB 供电。优先打通麦克风采集、WAV 文件写入及读取验证，后续再优化自动语音触发、功耗、阈值和长期可靠性。

本轮明确使用 EVT_USB_BENCH 测试入口，不把无电池状态误判为产品电池供电正常。不会自动格式化、删除或覆盖卡上文件；不操作其他串口、不更改 eFuse、不更换 SDK。

## 已取得证据

- 经所选串口识别 ESP32-S3 QFN56 revision v0.2，原生 USB Serial/JTAG。
- Flash 读取识别为 8 MB，Quad，芯片配置电压 3.3 V；这不是供电实测值。
- 覆盖写入前完整读出 8,388,608 byte Flash 备份，保存在未入库的本地证据目录。
- 备份 SHA256：`65CB41E20E59DCB4211076D7F170DF2565CD731ABA2A5980DE0BB378E494A0C9`。
- 当次统一电脑测试19/19通过；C核心14套ASan及UBSan共28/28通过。
- 测试固件已经所选串口烧录，bootloader/partition/app逐项写入哈希校验通过；应用USB命令正常。
- SD卡初始化与扇区读取成功：124,735,488个512-byte扇区，第一MBR分区type=0x07/start=32768，卷启动扇区EXFAT签名成立。用户当时确认是一张新购闪迪 64 GB 卡；型号和 CID 未记录。原FAT32固件挂载返回FatFs13（FR_NO_FILESYSTEM），不是没有卡、也不是没有格式化。
- 项目采用 exFAT 支持并保留现有格式/数据。项目内兼容配置独立构建通过，14个FatFs消费者配置审计通过，C/C++ ABI探针通过；全局SDK跟踪文件保持干净。
- exFAT实卡挂载通过，卷总容量63,831,015,424byte，首次空闲63,830,622,208byte；此时未创建录音。初始MC100命名文件列表为空（不代表其他用户目录为空）。

## 麦克风独立采集实测

本表使用`capture`，只消费/统计PCM，不执行SD文件操作；`saved=0`。VAD禁用，左槽是初始配置，非零数据不能替代采样沿/听感验证。

| 时长 | 帧数/样本数 | 实际流程耗时 | 最小/最大样本 | 溢出/丢帧 | 队列峰值 |
| --- | --- | --- | --- | --- | --- |
| 3秒 | 150 / 48,000 | 3,043ms | 1267 / 3755 | 0 / 0 | 1 |
| 60秒 | 3,000 / 960,000 | 60,043ms | 1235 / 3772 | 0 / 0 | 1 |

两次结束内部空闲堆均173,988byte；Audio最小剩余栈5,052byte，Storage9,832byte；均正常静止并`reset_required=0`。耗时包括启动丢弃40ms，不是用已知音调测出的采样率精度。样本呈明显正偏置，后续须分析PCM均值/交流分量和实际声音，不能宣称声学质量通过。

采集固件app SHA256：`1343946879E3376BF9E1058F22BD982861B784896EF768858396CB22822A747A`。

## exFAT录音落盘与读回

首轮exFAT app SHA256：`00FC281AFEDA8C03148FDDDE650E8700AEAE7F0ED82DF50DBC44DDA4FD6BAF01`，317,456byte。SDK为锁定v6.1，ESP32-S3，无PSRAM，80MHz CPU，SDMMC1-bit20MHz。后续栈余量修正镜像单独记录如下。

首段3秒录音：150帧、48,000样本，零溢出/丢帧，队列峰值9，录制/收尾3,115ms；内部空闲堆130,940byte，Audio剩余栈5,048byte，Storage3,624byte。

音频96,512byte和索引2,304byte已通过所选串口分块CRC读回。独立Python标准库wave及索引校验器确认：16000Hz/16bit/mono、3.000秒、所有BLOCK数据CRC/记录CRC/连续序号及FINAL通过，无INCIDENT。WAV SHA256 `5766010ebb8bd8f72d93e61056208c43bcb14aced6451374f1d1ddac9bc480a5`；IDX SHA256 `48417d1554a032d9ad1e031e23a4444fd65705d2a4e96f8c2b46883636554f03`。

原始PCM均值1311.19、AC RMS139.09，无削顶。启动瞬态后第2/3秒AC波动很小；没有已知音源/用户听音，声学效果仍不判PASS。数据校验成功证明传输/文件链路，不证明声音质量。

305秒连续录音也已通过：15,250帧、4,880,000样本，流程耗时305,147ms；零溢出、零丢帧、队列峰值16，内部空闲堆仍130,940byte，Audio剩余栈5,048byte，Storage3,352byte（12KiB栈的27.3%）。

| 分段 | 音频/索引字节数 | 样本数/时长 | 源样本区间（右端不含） | 完整校验 |
| --- | --- | --- | --- | --- |
| generation2/segment0 | 9,600,512 / 169,344 | 4,800,000 / 300秒 | [48,000, 4,848,000) | 全部BLOCK CRC及2,638条索引、FINAL通过 |
| generation2/segment1 | 160,512 / 3,456 | 80,000 / 5秒 | [4,848,000, 4,928,000) | 全部BLOCK CRC及46条索引、FINAL通过 |

两段均完整下载后独立验证，不仅抽查头部；交界源序号连续且第二段没有追加重复预录。第一段WAV SHA256 `c5e69f43aa316fdd0af5da22f44bbc73801e93bb002ed57686582a35a4f4e341`，第二段 `426ea2ee0279b6127d12a46dd04a6c345cb9394ea4483626f8b78e6b8f32f300`。索引SHA256分别`8468dc9d8af7fe464d5db5e700ea5913f7bc476394afed81d124a62c24b315f4`和`1bc44d4ce62f3431629a31eaffd703ce386f151f4ab06d8a99372c40850aa72f`。

补充24项关闭故障测试（15个硬失败点、5次短写、2次目标名冲突、释放重试和正常字节对照）通过，独立审查通过。统一电脑测试19/19通过；最新核心ASan/UBSan28/28及新增收尾ASan通过。这不是实卡掉电试验。

原始日志与环境音保存在未入库的本地证据目录，不随仓库分发。首个已验证阶段已合入并推送远程主线`31a233a`，后续实测记录增量提交。

## 正常重启与栈余量修正

所有文件关闭后，仅经所选串口正常复位（不是录制中切电）。首次3秒WAV及索引重新完整读回，与重启前逐字节一致。重启后的新会话亦完整CRC校验通过，boot_id变化、名称未覆盖历史。

重启复用预留槽时，12KiB Storage栈最低余量2,520byte，低于设计25%门槛，判为资源门槛未通过而非忽略。只将Storage栈增加到16KiB，未改采样、队列、文件格式或写入逻辑。新目标构建和独立审查通过，所选串口烧录校验通过。

最终app SHA256：`412615AC0A11400D3E9D52ECA8959B615601234D38551A7B407693E0D4C13FEA`。当次镜像/bin/ELF/map/配置和烧录参数归档在未入库的本地证据目录；原8MB Flash备份仍保留。

新镜像烧录后及再次正常重启后各3秒录音通过，均150帧/48,000样本、零丢帧/溢出。实测Storage栈余量6,616byte（40.4%），Audio5,044byte；内部空闲堆126,856byte、最小122,048byte。最终会话完整WAV/索引读回及CRC/FINAL通过：WAV SHA256 `2dd9afa0ffae251b210ecf92832be5eaececd94676138cef17410451c5e6bebd`，IDX `dab5ba095aedd2a556db9a358186242a61fb41b55ba2f9804424d404ee955a75`。新镜像未重跑完整305秒；长录音证据属于上述旧镜像，差异仅Storage栈与构建版本元数据。

最终板子处于待命，`mounted=1 reset_required=0`；不会自动录音。全程未接触其他COM口，未格式化/删除/覆盖SD历史文件，未更改eFuse或全局SDK。

## 仍需验证

- 自动VAD、完整产品状态集成及启动恢复。
- 已知声源/人声听感、采样率精度与槽位、电池/功耗、真实拔卡/断电、多卡及长时耐久。

人工听感、人声灵敏度、电池校准、真实电源波形、整机功耗和耐久试验不由自动台架测试替代。未经运行的项目保持未验证。
