ywbdxxm/MC100/docs/reports/2026-09-19-exfat-decision.md

# MC100 FAT32 / exFAT兼容决策

本次实验使用一张 64 GB exFAT 卡，项目采用 exFAT 支持并保留卡上现有数据。此决定扩展原设计中“仅FAT32、32GB目标卡”的范围，其他录音格式/安全边界不变。

## 已确认根因

卡初始化、MBR和卷启动扇区读取成功，卷存在EXFAT签名。原固件FatFs返回FR_NO_FILESYSTEM；固定SDK的`ffconf.h`硬编码关闭exFAT，单独加编译宏会被覆盖。

## 采用方案

在项目CMake为FatFs及其消费者传递同一个强制包含配置头：先包含原SDK配置，再启用exFAT。只作用于C/C++，不修改全局SDK或替换文件系统实现。保留原配置版本/SDK锁检查，编译探针确认所有`FSIZE_t`使用一致64位布局；FAT32继续支持。

不复制或维护整套SDK组件。每个录音文件仍最多9,600,000byte PCM，适配层保留32位文件操作上限；64GB卷容量/空闲空间用64位计算，不宣称通用大于4GB文件支持。

## 保持的安全约束

- 不格式化、不删除历史文件，不替换已存在的目标名称。
- 单一Storage所有者，显式同步后关闭；错误状态不通过隐式close补写。
- PCM预分配不代表内容有效；整个索引预清零，只有连续CRC索引覆盖的数据有效。
- exFAT重命名同样不是抗任意掉电的原子事务；写入/重命名掉电及恢复仍需单独验收。
- WAV和索引v1布局不变，五分钟轮换与预录边界不变。

## 验证门槛

负向编译证明未启用时被拒绝；独立干净目标构建；消费者配置传播审计和C/C++ ABI探针；原SDK保持干净；实卡挂载、独占新建、同步关闭、WAV/索引读回及CRC检查；重复会话、五分钟轮换及正常重启读回。结果记录在[台架报告](2026-09-19-evt-recording.md)，不预先标PASS。
