ywbdxxm/MC100/docs/MC100-ROADMAP.md

# MC100 项目路线图

目标是先把最小录音产品做成可重复验证的闭环，再增加会改变资源、功耗或数据语义的功能。每阶段完成前，不把后阶段代码接入默认 product profile。

## P0：录音和存储闭环

当前阶段。

- product 上电自动录音，默认 20 秒，录音中持续写入 SD。
- 处理链固定为 PDM → PCM → 可选 DC blocking → 数字增益 → WAV/IDX writer。
- 在目标板完成 boot、mount、recording、stop、IDLE 日志。
- 从 SD 取出 WAV/IDX，完成参数、连续序号、CRC、FINAL 和时长验证。
- 记录输入/输出峰值、削波、队列峰值、堆和任务栈余量。

退出条件：同一 product 镜像在至少一张目标 SD 卡上完成一次干净短录音，日志和读卡器 verifier 都通过；构建、Host 和实板证据分开归档。

## P1：存储可靠性

- 验证约 300 秒分段轮换和跨段序号连续性。
- 覆盖满卡、空间不足、短写、文件名冲突、挂载失败和拔卡策略。
- 明确正常复位和异常复位后的恢复行为。
- 进行连续数小时耐久，记录丢帧、堆、栈和文件完整性。

退出条件：每个故障都有明确的日志状态和文件语义；未完成文件不会被误报为 clean recording。

## P2：音频和自动结束

- 在固定声源、距离和声孔方向下评估数字增益和 DC blocking。
- 只有资源预算稳定后，比较轻量 VAD 与其它候选。
- 定义静音结束、预录长度、误启动和漏检指标。

退出条件：候选 VAD 在目标内存和时钟配置上可运行，并有授权语料的召回、误启动和延迟数据。

## P3：电池和耐久

- 标定电池 ADC，定义低电阈值和边充边录行为。
- 测量 PDM、SD 写入和空闲状态的实际电流、温升和录音时长。
- 扩展掉电、重复启动和长时间循环测试。

退出条件：功耗和电池策略由仪器数据支持，且不会破坏 P0/P1 文件完整性。

## P4：无线

- 单独定义无线协议、缓存、失败重试、凭据和数据删除策略。
- 评估无线与录音/SD 的任务、内存和功耗竞争。
- 在无线未稳定前保持本地录音可独立工作。

退出条件：无线是可选传输层，不改变 WAV/IDX 本地落盘协议，断网时录音仍满足 P0/P1。

## 当前执行顺序

下一项工作从 P0 开始：最近一次 product 复位停在 ROM `DOWNLOAD (boot:0x0)`，先检查 GPIO0/BOOT 和复位条件，再用目标板实际枚举出的串口完成短录音，并断电取卡做 WAV/IDX 读卡器校验。
