ywbdxxm/MC100/docs/MC100-DEVELOPMENT-STATUS.md

# MC100 软件开发与实板台架进度

执行范围已按用户最新要求调整：实板已连接，只允许 COM7；SD 卡已插入，USB 供电、无电池。先完成并实测“采集→SD WAV”，用户无需在场配合的测试自动执行。完整 VAD、恢复、功耗和耐久验收仍分别保留，不把台架切片当成完整产品。已授权分阶段合入主线并推送远程。

## 当前任务

| 任务 | 状态 | 证据/下一步 |
| --- | --- | --- |
| T01 工程/BSP/测试入口 | PASS | 原生 CTest 1/1、脚本安全负例、ESP32-S3 干净构建通过；独立审查通过，提交 a93de0e |
| T02 状态/电池策略 | PASS_CORE | 审查问题已修复并复审通过；不等于电池实测/产品运行集成完成 |
| T03 组帧/预录/队列 | PASS_CORE | 含100万帧逐样本检查，统一测试及独立审查通过；实板采集零丢帧见报告 |
| T04 WAV/索引/CRC | PASS | 统一 CTest 4/4、目标干净构建、独立审查通过，提交8eb35dc；不代表存储事务/恢复已完成 |
| T05 写入/轮换/空间 | PASS_CORE | 四项电脑测试、真实目录适配、独立审查通过；实卡验证推进中 |
| T06 恢复/扇区故障 | BLOCKED | 恢复核心复审通过；精确 SDK 的 exFAT 扇区门禁失败，不能宣称任意掉电恢复 |
| T07 VAD/语料评估 | NOT_STARTED | 真实语料评估不可由强制语音标记替代 |
| T08 同源端到端仿真 | DEFERRED | 用户优先实测；不能将延期项写为通过 |
| T09 IDF 外设适配 | EVT_SLICE_PASS | 3秒与60秒采集通过；64GB exFAT的3秒及305秒录音完整CRC读回、300+5秒精确分段通过；声学/电气仍待测 |
| T10 监控/配置/诊断 | NOT_STARTED | 低电参数保留 EVT 标识 |
| T11 任务集成/资源 | EVT_SLICE | 单独Audio/Storage所有者；实测后Storage栈调至16KiB，余量40.4%，最终内部空闲堆126,856byte；完整自动State/VAD运行未完成 |
| T12 CI/候选包 | NOT_STARTED | 所有软件门禁通过才标 SW_READY_FOR_EVT |
| T13–T14 实板验证 | PARTIAL | 已有板，按安全顺序推进；电池、仪器、拔卡/断电和长期测试未执行 |

## 执行规则

- 本地开发分支隔离主分支历史；保留硬件 PDF、现有设计文档和用户配置。`PCB1.epro2` 已删除，仓库禁止嘉立创/EasyEDA 工程文件。
- 每个功能先运行失败测试，再实现并运行通过测试；开发脚本也验证失败退出与输出隔离。
- 支持对独立检查和任务审查使用子代理；所有实际修改有明确文件所有权。
- 不自动安装/替换全局 SDK；只烧录 COM7。阶段验证/审查通过后合入并推送，不强推。
- 不格式化、不删除或覆盖SD现有文件；真实录音与Flash备份留在忽略目录，不上传远程。
- 硬件快照身份及引脚继续以 [验证矩阵](MC100-VALIDATION.md) 为准；硬件事实以 `hardware/` 下 PDF 快照为准，不依赖云工程。

## 当前已取得的软件证据

2026-09-19最新统一测试19/19通过；14套C核心测试分别运行ASan/UBSan，共28/28通过，补充收尾24场景原生及ASan通过。目标固件按固定ESP-IDF构建和分区检查通过。原8MB Flash完整备份后才写入台架固件，芯片写入哈希校验通过。实际采集、卡格式与尚未完成项目见[实板报告](reports/2026-09-19-evt-recording.md)。

2026-09-19：WAV 编码检查 0/2/640/9,600,000 byte 与非法奇数/越界长度；CRC 已知向量；64 byte 索引记录和512 byte头的每一位损坏均拒绝，重算 CRC 后的非法版本/保留字段也被拒绝。原生 MSVC C11 `/W4 /WX` 编译无告警、执行退出0。独立 Python 标准库 wave 校验 C 产出的 WAV 格式与320个样本，1/1通过。此结果只覆盖文件格式，不代表 SD 写入/断电恢复已实现。
