ywbdxxm/MC100/hardware/PCB_PCB1_2026-09-18.pdf

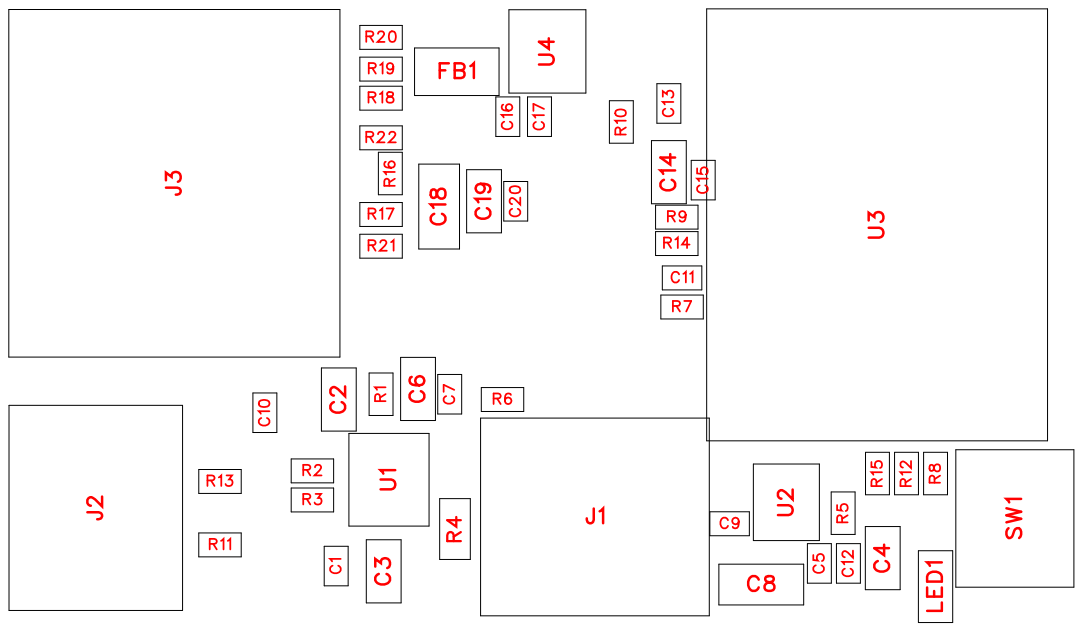
[picture p1: page 1]

TP1
TP2

TP3

TP4

No. | Quantity | Comment | Designator | Footprint | Value | Manufacturer Part | Manufacturer | Supplier Part | Supplier
1 | 10 | 100nF | C1,C5,C7,C9,C10,C11,C12, C15,C17,C20 | C0402 | 100nF | CL05B104K O5NNNC | SAMSUNG( 三星) | C1525 | LCSC
2 | 6 | 10uF | C2,C3,C4,C6,C14,C19 | C0603 | 10uF | CL10A106KP 8NNNC | SAMSUNG( 三星) | C19702 | LCSC
3 | 1 | 22uF | C8 | C0805 | 22uF | CL21A226M AQNNNE | SAMSUNG( 三星) | C45783 | LCSC
4 | 2 | 1uF | C13,C16 | C0402 | 1uF | CL05A105KA 5NQNC | SAMSUNG( 三星) | C52923 | LCSC
5 | 1 | 47uF | C18 | C0805 | 47uF | CL21A476M QYNNNE | SAMSUNG( 三星) | C16780 | LCSC
6 | 1 | GZ2012D601 TF | FB1 | L0805 | | GZ2012D601 TF | Sunlord(顺络 ) | C1017 | LCSC
7 | 1 | HDGC2001 WR-S-3P | J1 | CONN-SMD_ 3P-P2.00_H DGC_HDGC 2001WR-S-3 P | | HDGC2001 WR-S-3P | HDGC(华德 共创) | C2936225 | LCSC
8 | 1 | TYPE-C-31-M-12 | J2 | USB-C_SMD -TYPE-C-31-M-12_1 | | TYPE-C-31-M-12 | 韩国韩荣 | C165948 | LCSC
9 | 1 | TF PUSH | J3 | TF-SMD_TF-PUSH | | TF PUSH | SHOU HAN(首韩) | C393941 | LCSC
10 | 1 | A-SP192DG HC-C01-4T | LED1 | LED0603-FD | | A-SP192DG HC-C01-4T | Amicc(欧密格 光电) | C19171301 | LCSC
11 | 2 | 3k | R1,R3 | R0402 | 3k | 0402WGF30 01TCE | UNI-ROYAL( 厚声) | C25784 | LCSC
12 | 1 | 46.4k | R2 | R0402 | 46.4k | 0402WGF46 42TCE | UNI-ROYAL( 厚声) | C52378 | LCSC
13 | 1 | 0 | R4 | R0603 | 0 | FRC0603F00 00TS | FOJAN(富捷) | C2906974 | LCSC
14 | 1 | 100k | R5 | R0402 | 100k | 0402WGF10 03TCE | UNI-ROYAL( 厚声) | C25741 | LCSC
15 | 1 | 1M | R6 | R0402 | 1M | 0402WGF10 04TCE | UNI-ROYAL( 厚声) | C26083 | LCSC
16 | 1 | 330k | R7 | R0402 | 330k | 0402WGF33 03TCE | UNI-ROYAL( 厚声) | C25778 | LCSC
17 | 1 | 3.3k | R8 | R0402 | 3.3k | 0402WGF33 01TCE | UNI-ROYAL( 厚声) | C25890 | LCSC
18 | 8 | 10k | R9,R10,R16,R17,R18,R19, R20,R21 | R0402 | 10k | 0402WGF10 02TCE | UNI-ROYAL( 厚声) | C25744 | LCSC
19 | 2 | 5.1k | R11,R13 | R0402 | 5.1k | 0402WGF51 01TCE | UNI-ROYAL( 厚声) | C25905 | LCSC
20 | 4 | 22 | R12,R14,R15,R22 | R0402 | 22 | 0402WGF22 0JTCE | UNI-ROYAL( 厚声) | C25092 | LCSC
21 | 1 | HX MINI MSK12CO2 | SW1 | SW-SMD_M SK12CO2 | | HX MINI MSK12CO2 | hanxia(韩下) | C5149840 | LCSC

22 | 4 | Test-Point | TP1,TP2,TP3,TP4 | Test-Point-0. 5mm
23 | 1 | BQ24073RG TR | U1 | QFN-16_L3.0 -W3.0-P0.50-TL-EP1.7 | BQ24073RG TR | TI(德州仪器 ) | C15220 | LCSC
24 | 1 | TLV75733PD BVR | U2 | SOT-23-5_L2 .9-W1.6-P0.9 5-LS2.8-BL | TLV75733PD BVR | TI(德州仪器 ) | C485517 | LCSC
25 | 1 | ESP32-S3-M INI-1-N8 | U3 | BULETM-SM D_ESP32-S3 -MINI-1-N8 | ESP32-S3-M INI-1-N8 | ESPRESSIF( ) 乐鑫 | C2913206 | LCSC
26 | 1 | ZTS6872SE | U4 | LGA-SMD_L 3.5-W2.7-P0. 82_ZTS6872 SE | ZTS6872SE | ZILLTEK( 钰 ) 太 | C42372687 | LCSC

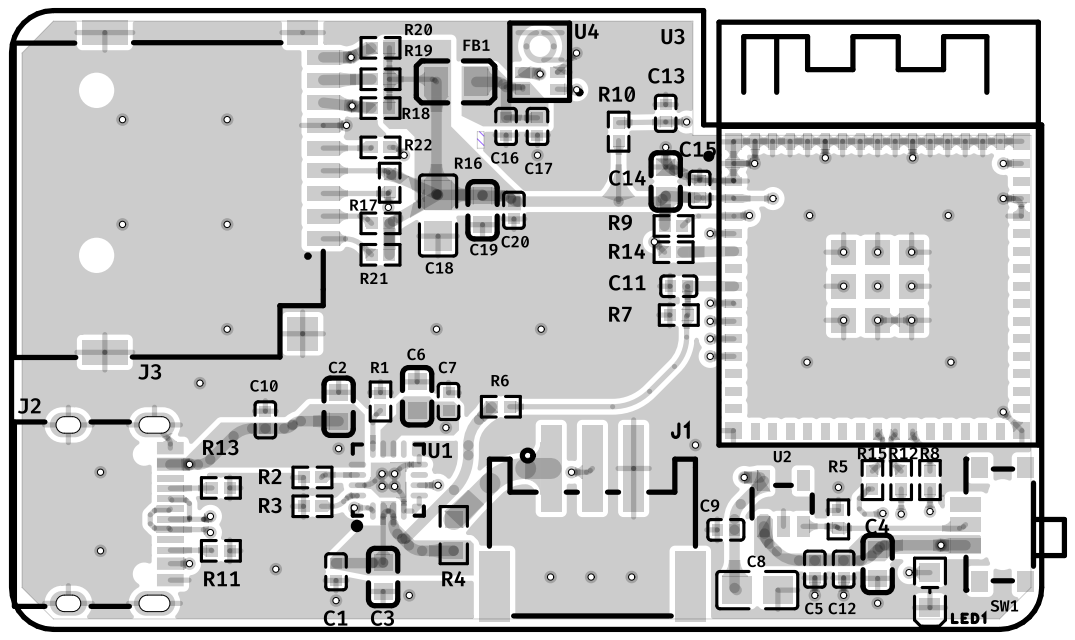
[picture p2: page 5]

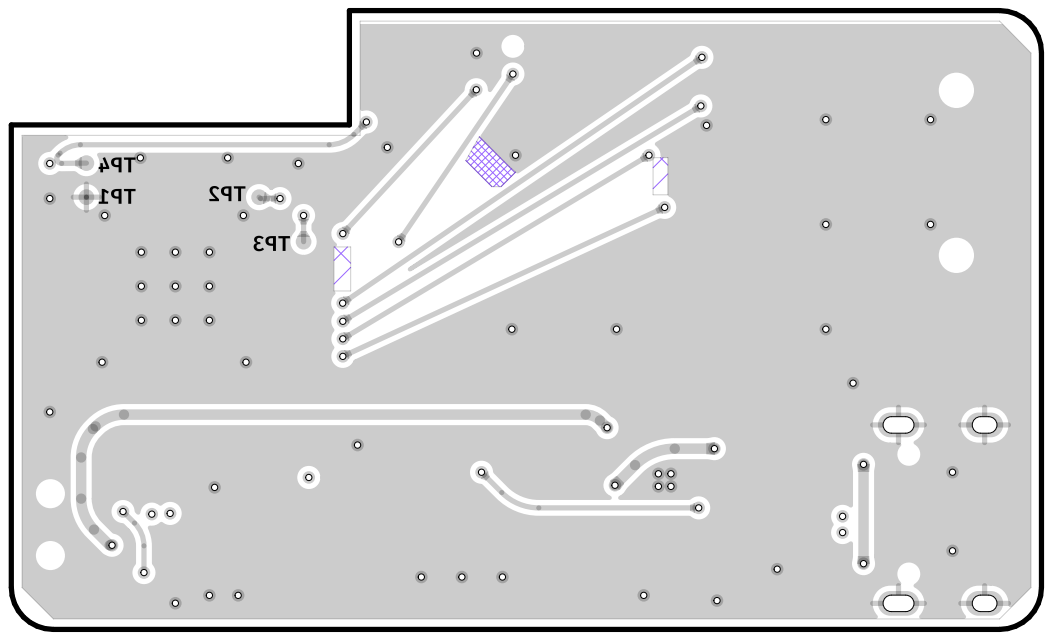
[picture p3: page 6]

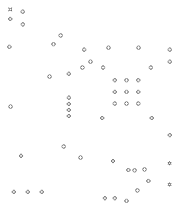
[picture p4: figure]
