ywbdxxm/MC100/hardware/SCH_Schematic1_2026-09-18.pdf

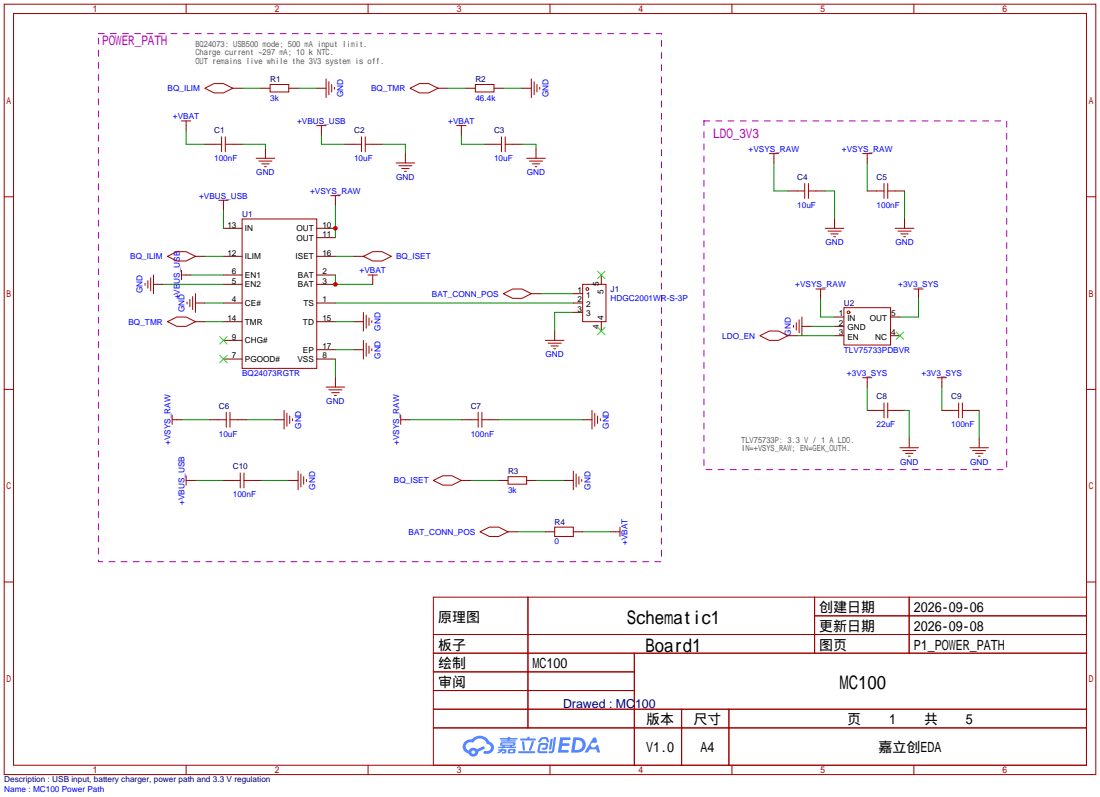
[picture p5: page 1]

BQ24073: USB500 mode; 500 mA input limit.
Charge current ~297 mA; 10 k NTC.
OUT remains live while the 3V3 system is off.

原理图 | Schematic1 | 创建日期 | 2026-09-06

更新日期 | 2026-09-08

板子 | Board1 | 图页 | P1_POWER_PATH
绘制 | MC100 | MC100
审阅

Drawed : MC100

V1.0 | A4 | 嘉立创EDA

Description : USB input, battery charger, power path and 3.3 V regulation
Name : MC100 Power Path

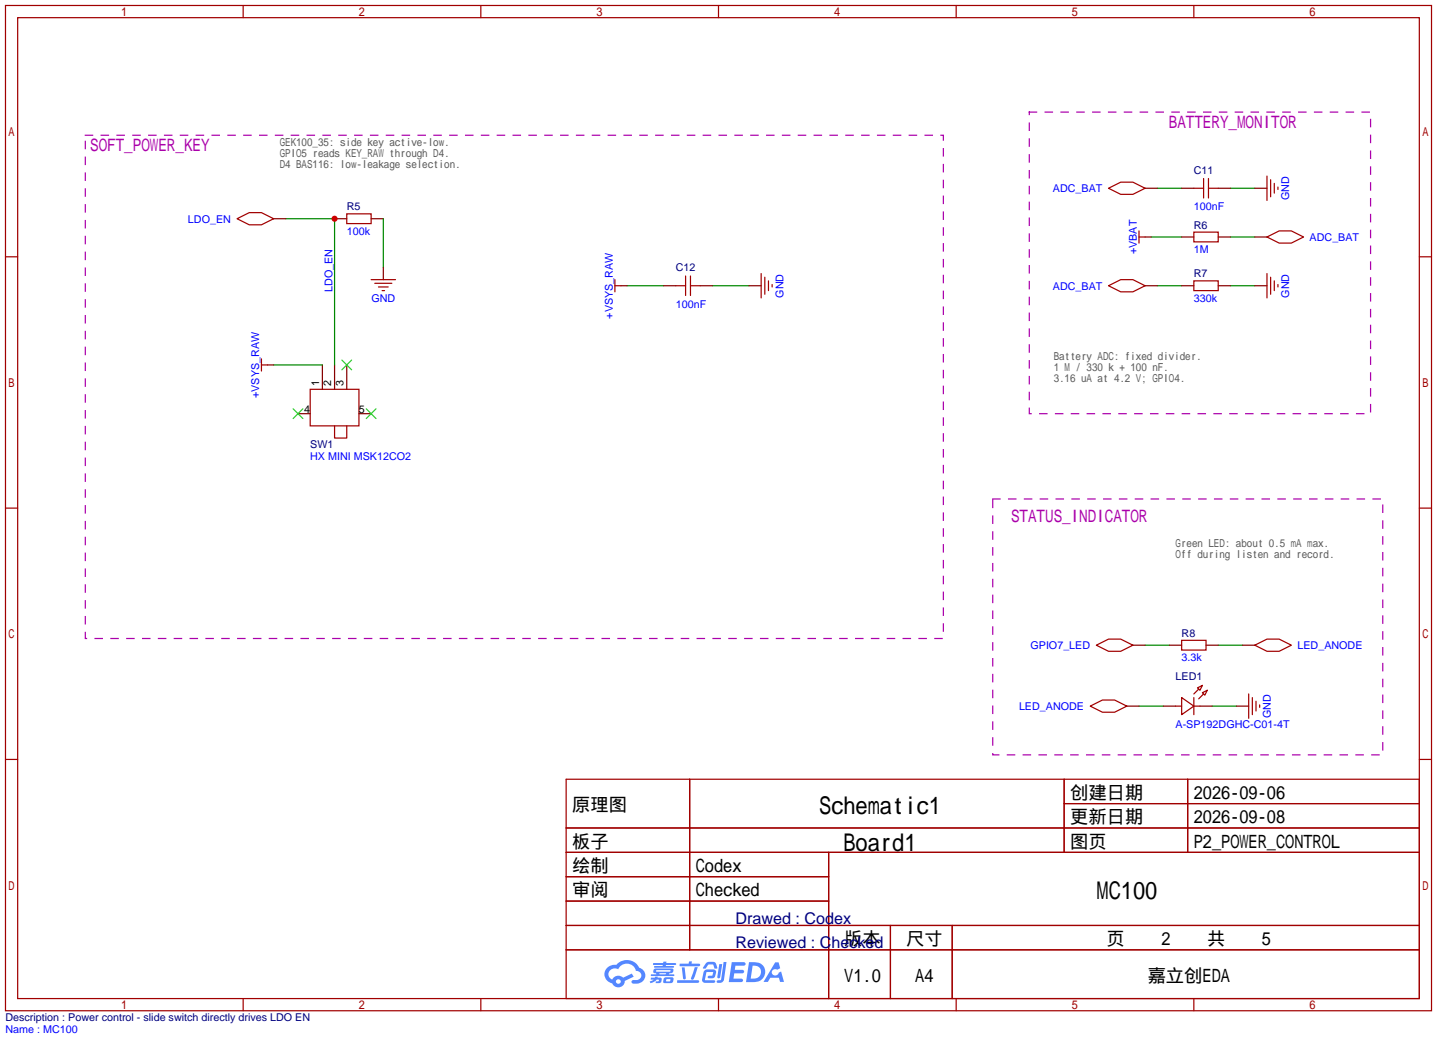
[picture p6: page 2]

GEK100_35: side key active-low.
GPIO5 reads KEY_RAW through D4.
D4 BAS116: low-leakage selection.

Battery ADC: fixed divider.
3.16 uA at 4.2 V; GPIO4.

Green LED: about 0.5 mA max.
Off during listen and record.

原理图 | Schematic1 | 创建日期 | 2026-09-06

更新日期 | 2026-09-08

板子 | Board1 | 图页 | P2_POWER_CONTROL
绘制 | Codex | MC100
审阅 | Checked

Drawed : Codex
Reviewed : Checked | 版本 | 尺寸 | 页 2 共 5

Description : Power control - slide switch directly drives LDO EN
Name : MC100

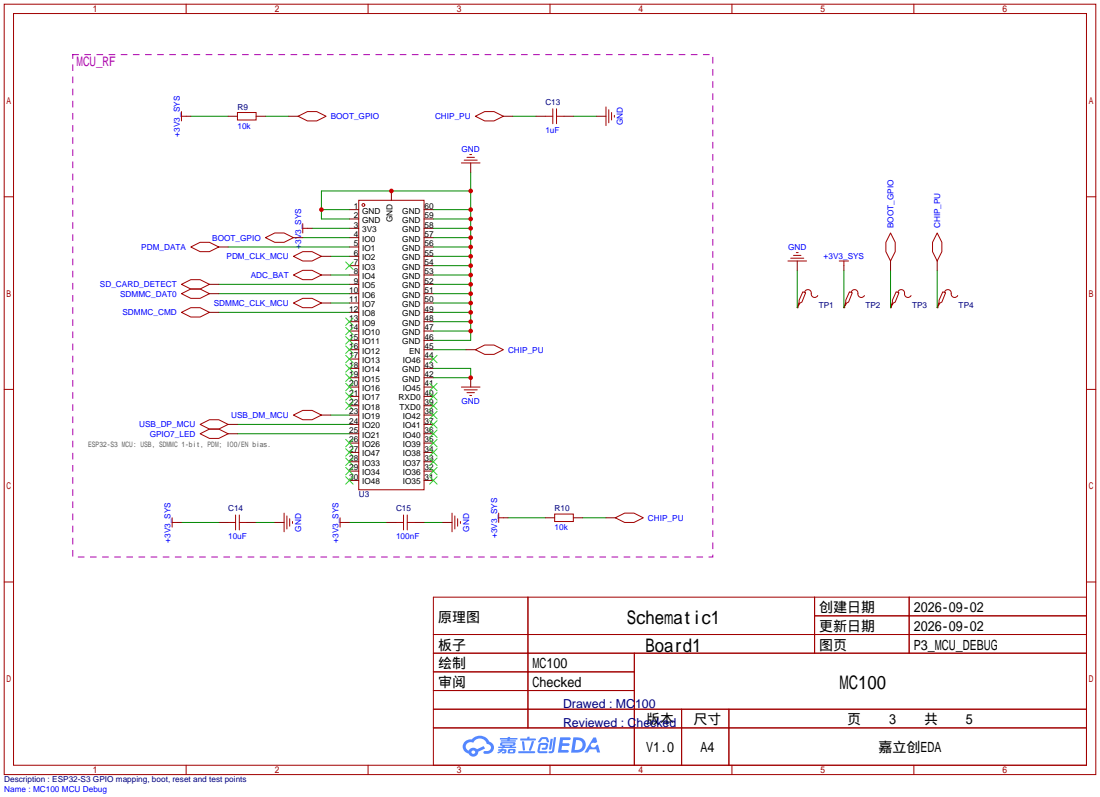
[picture p7: page 3]

ESP32-S3 MCU: USB, SDMMC 1-bit, PDM; IO0/EN bias.

原理图 | Schematic1 | 创建日期 | 2026-09-02

更新日期 | 2026-09-02

板子 | Board1 | 图页 | P3_MCU_DEBUG
绘制 | MC100 | MC100
审阅 | Checked

Drawed : MC100
Reviewed : Checked | 版本 | 尺寸 | 页 3 共 5

Description : ESP32-S3 GPIO mapping, boot, reset and test points
Name : MC100 MCU Debug

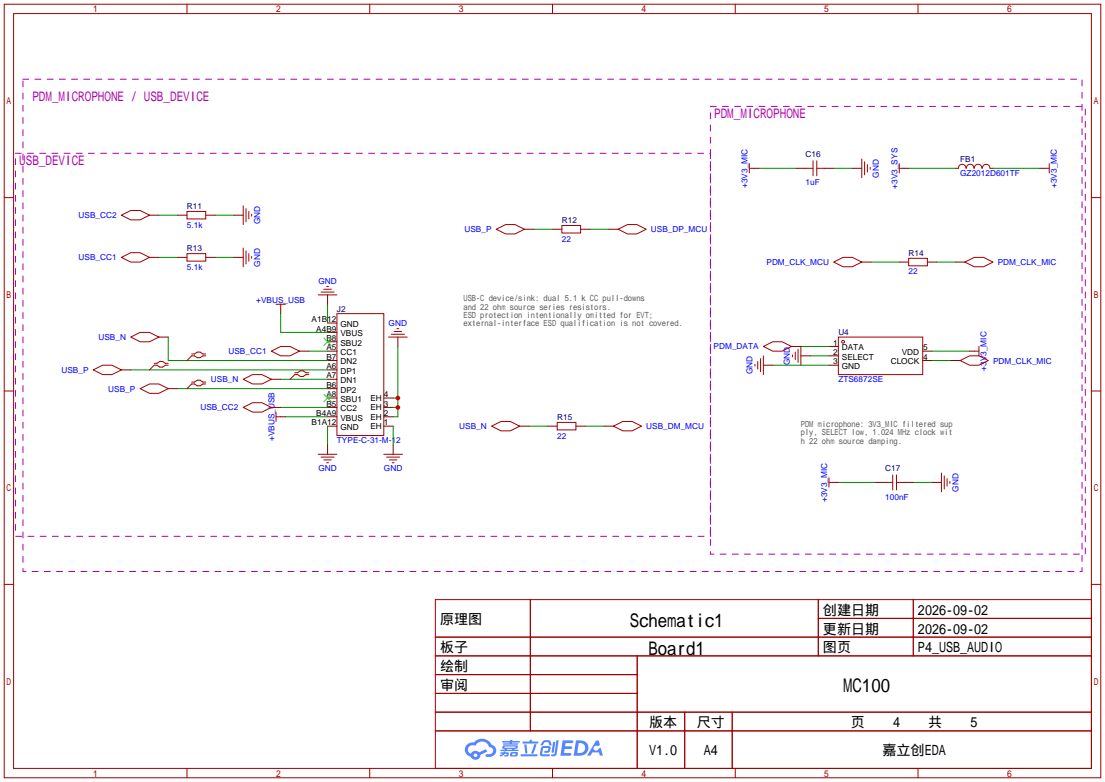
[picture p8: page 4]

USB-C device/sink: dual 5.1 k CC pull-downs
and 22 ohm source series resistors.
ESD protection intentionally omitted for EVT;
external-interface ESD qualification is not covered.

PDM microphone: 3V3_MIC filtered sup
ply, SELECT low, 1.024 MHz clock wit
h 22 ohm source damping.

原理图 | Schematic1 | 创建日期 | 2026-09-02

更新日期 | 2026-09-02

板子 | Board1 | 图页 | P4_USB_AUDIO
绘制 | | MC100
审阅

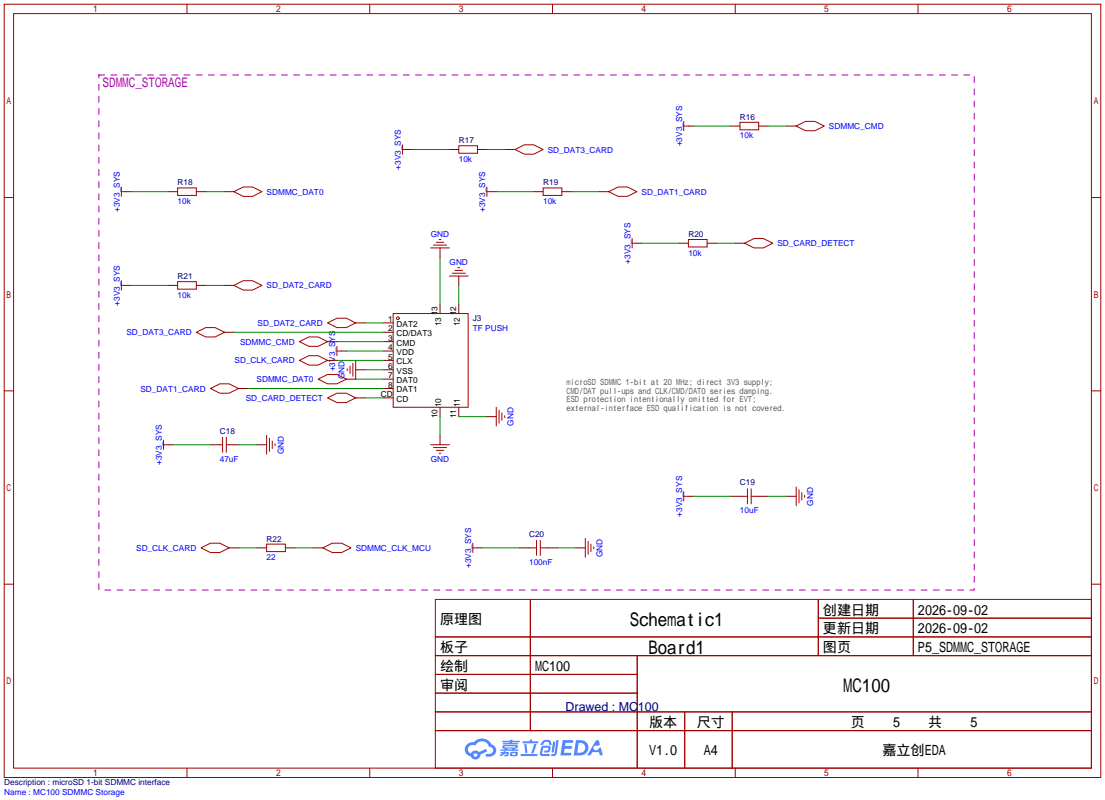
[picture p9: page 5]

microSD SDMMC 1-bit at 20 MHz; direct 3V3 supply;
CMD/DAT pull-ups and CLK/CMD/DAT0 series damping.
ESD protection intentionally omitted for EVT;
external-interface ESD qualification is not covered.

原理图 | Schematic1 | 创建日期 | 2026-09-02

更新日期 | 2026-09-02

板子 | Board1 | 图页 | P5_SDMMC_STORAGE
绘制 | MC100 | MC100
审阅

Drawed : MC100

Description : microSD 1-bit SDMMC interface
Name : MC100 SDMMC Storage
