ywbdxxm/MC100/(commit log)

2026-09-18 build: establish MC100 target and host baseline
    [partitions.csv]
2026-09-18 feat: define recorder lifecycle and battery policy
2026-09-18 fix: preserve fault prefixes and canceled audio grants
    [test_state.c]
2026-09-18 feat: recover validated audio prefixes after interrupted writes
2026-09-18 feat: handle finalized recovery states and reserved slots
2026-09-18 fix: validate reserved index contents during recovery
    [test_recover_idempotent.c]
2026-09-19 fix: enforce recovery cleanup and deadlines
    [test_recover_idempotent.c, test_recover_prefix.c]
2026-09-23 fix: gate supervisor ready on prepared storage and readiness
    [supervisor_test_support.h, test_supervisor_boot.c]
2026-09-23 fix: harden supervisor boot safety and cleanup
    [supervisor_test_support.h, test_supervisor_boot.c]
2026-09-23 feat: wire ESP-IDF product runtime to supervisor
2026-09-23 fix: add product power monitor and retry owner cleanup
    [product_runtime.c, test_supervisor_edges.c]
2026-09-23 docs: record COM7 esp-sr runtime gate as blocked
    Phase 1 remains OPEN: PM/PDM and libfvad evidence is partial, while the COM7-only esp-sr VADNet probe reached model discovery but failed AFE creation with internal-memory exhaustion and panic. Preserve target-build PASS, keep VAD selection, corpus, and current measurements open, and scope the failure to the tested no-PSRAM configuration.
2026-09-23 fix: quarantine product audio worker on shutdown failure
    [product_runtime.c, test_product_audio_protocol.c]
2026-09-24 fix: allow MC100 recorder first frame startup
    [test_record_session.c]
2026-09-24 docs: align product battery behavior
2026-09-25 MC100: add portable PCM audio filter
